novi/ossc_pcb/case-soundbox/nextcube-ext-card-mo-mount.dxf

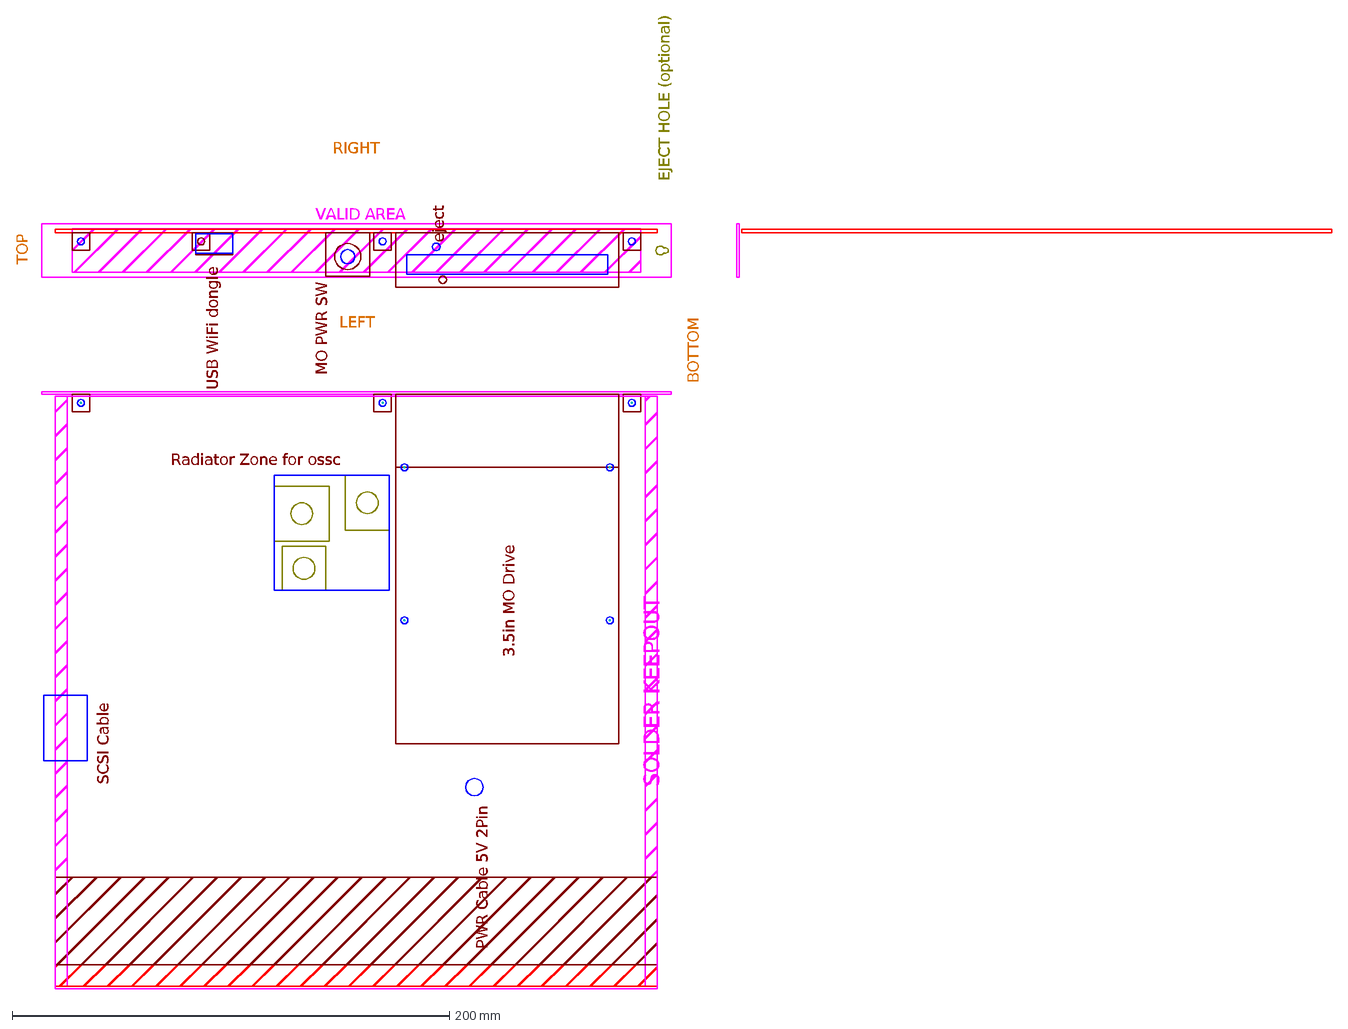
[picture p1: CAD file, 2021-07-24]
case-soundbox/nextcube-ext-card-mo-mount.dxf
VALID AREA
EJECT HOLE (optional)
BOTTOM
TOP
RIGHT
LEFT
SOLDER KEEPOUT
3.5in MO Drive
eject
MO PWR SW
USB WiFi dongle
SCSI Cable
PWR Cable 5V 2Pin
Radiator Zone for ossc
