novi/ossc_pcb/case-soundbox/nextcube-ext-card-soundbox-mount-alt1.dxf

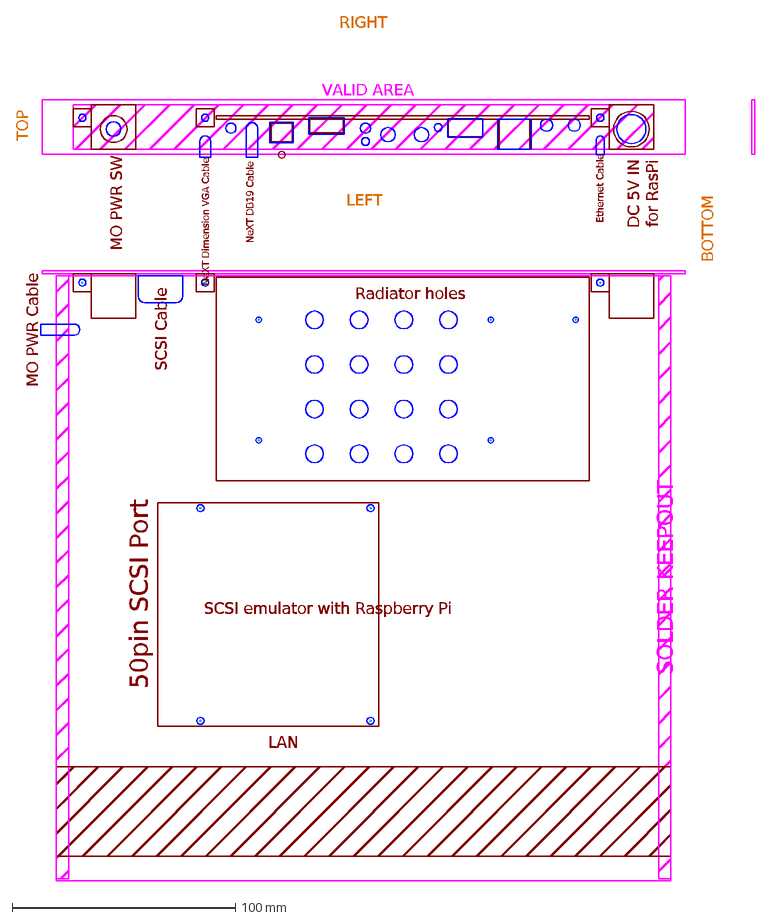
[picture p2: CAD file, 2021-07-11]
case-soundbox/nextcube-ext-card-soundbox-mount-alt1.dxf
VALID AREA
BOTTOM
TOP
RIGHT
LEFT
SOLDER KEEPOUT
50pin SCSI Port
LAN
MO PWR SW
DC 5V IN for RasPi
Ethernet Cable
NeXT DB19 Cable
NeXT Dimension VGA Cable
SCSI Cable
MO PWR Cable
Radiator holes
SCSI emulator with Raspberry Pi
