novi/ossc_pcb/case-soundbox/nextcube-ext-card-soundbox-mount.dxf

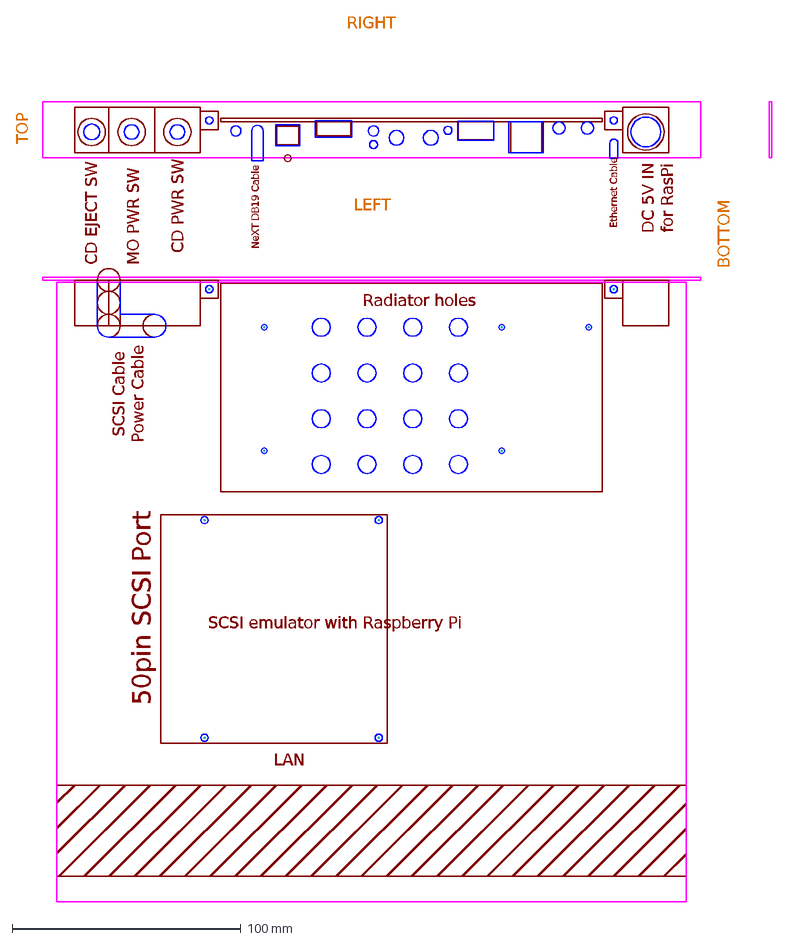
[picture p3: CAD file, 2021-05-28]
case-soundbox/nextcube-ext-card-soundbox-mount.dxf
BOTTOM
TOP
RIGHT
LEFT
50pin SCSI Port
LAN
CD EJECT SW
MO PWR SW
CD PWR SW
DC 5V IN for RasPi
Ethernet Cable
NeXT DB19 Cable
SCSI Cable Power Cable
Radiator holes
SCSI emulator with Raspberry Pi
