novi/ossc_pcb/case-soundbox/nextcube-3-and-half-mo-mount.dxf

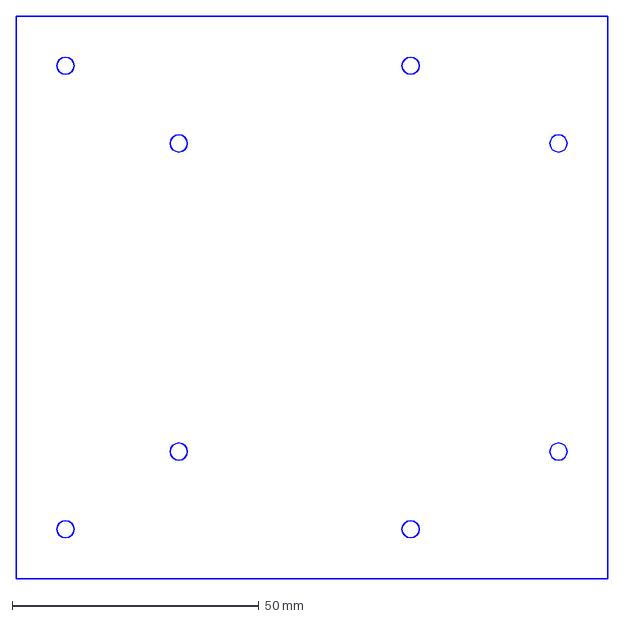
[picture p4: CAD file, 2020-09-13]
case-soundbox/nextcube-3-and-half-mo-mount.dxf
120.0 x 114.0 mm
