novi/ossc_pcb/case-soundbox/nextcube-ext-card.dxf

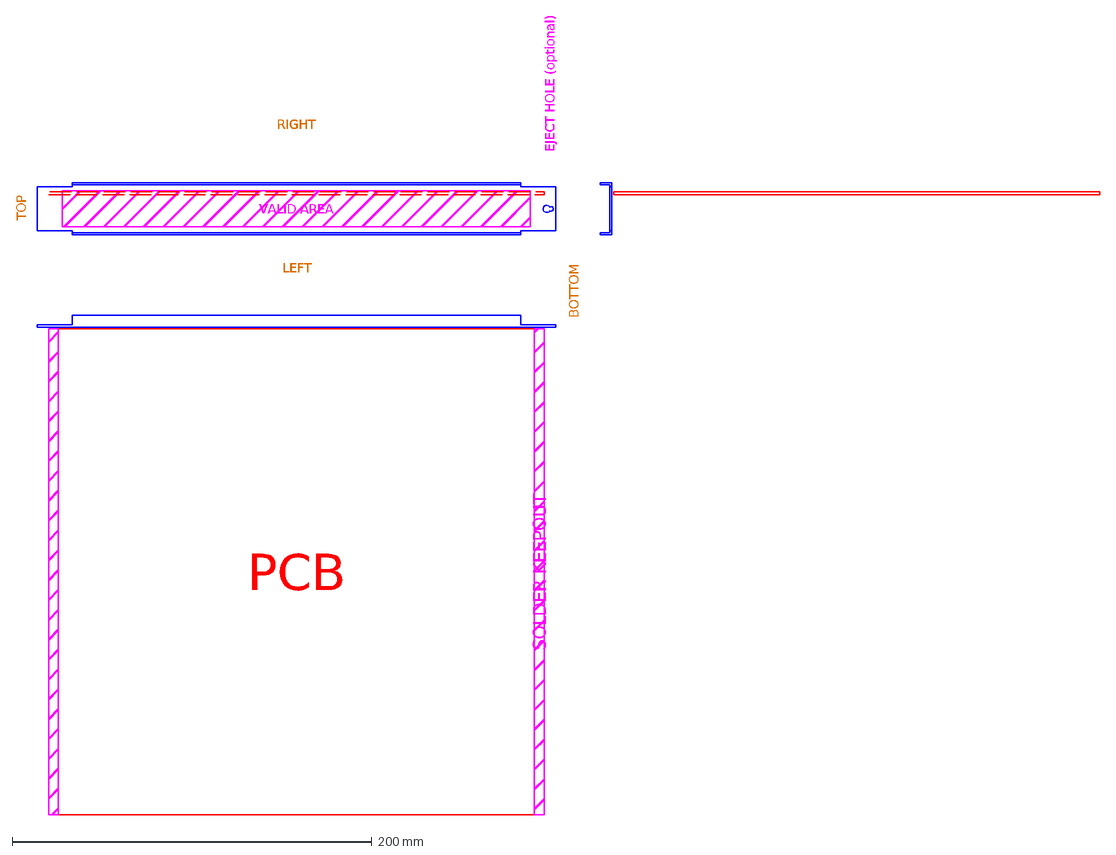
[picture p5: CAD file, 2020-09-13]
case-soundbox/nextcube-ext-card.dxf
VALID AREA
EJECT HOLE (optional)
BOTTOM
TOP
RIGHT
LEFT
PCB
SOLDER KEEPOUT
