novi/ossc_pcb/(list of files, cad)

Other CAD files:
case-soundbox/PF15-3-10D_20210228210419.dxf
