novi/ossc_pcb/ossc_board.kicad_pcb

## KiCad design ossc_board.kicad_pcb (2026-04-06)

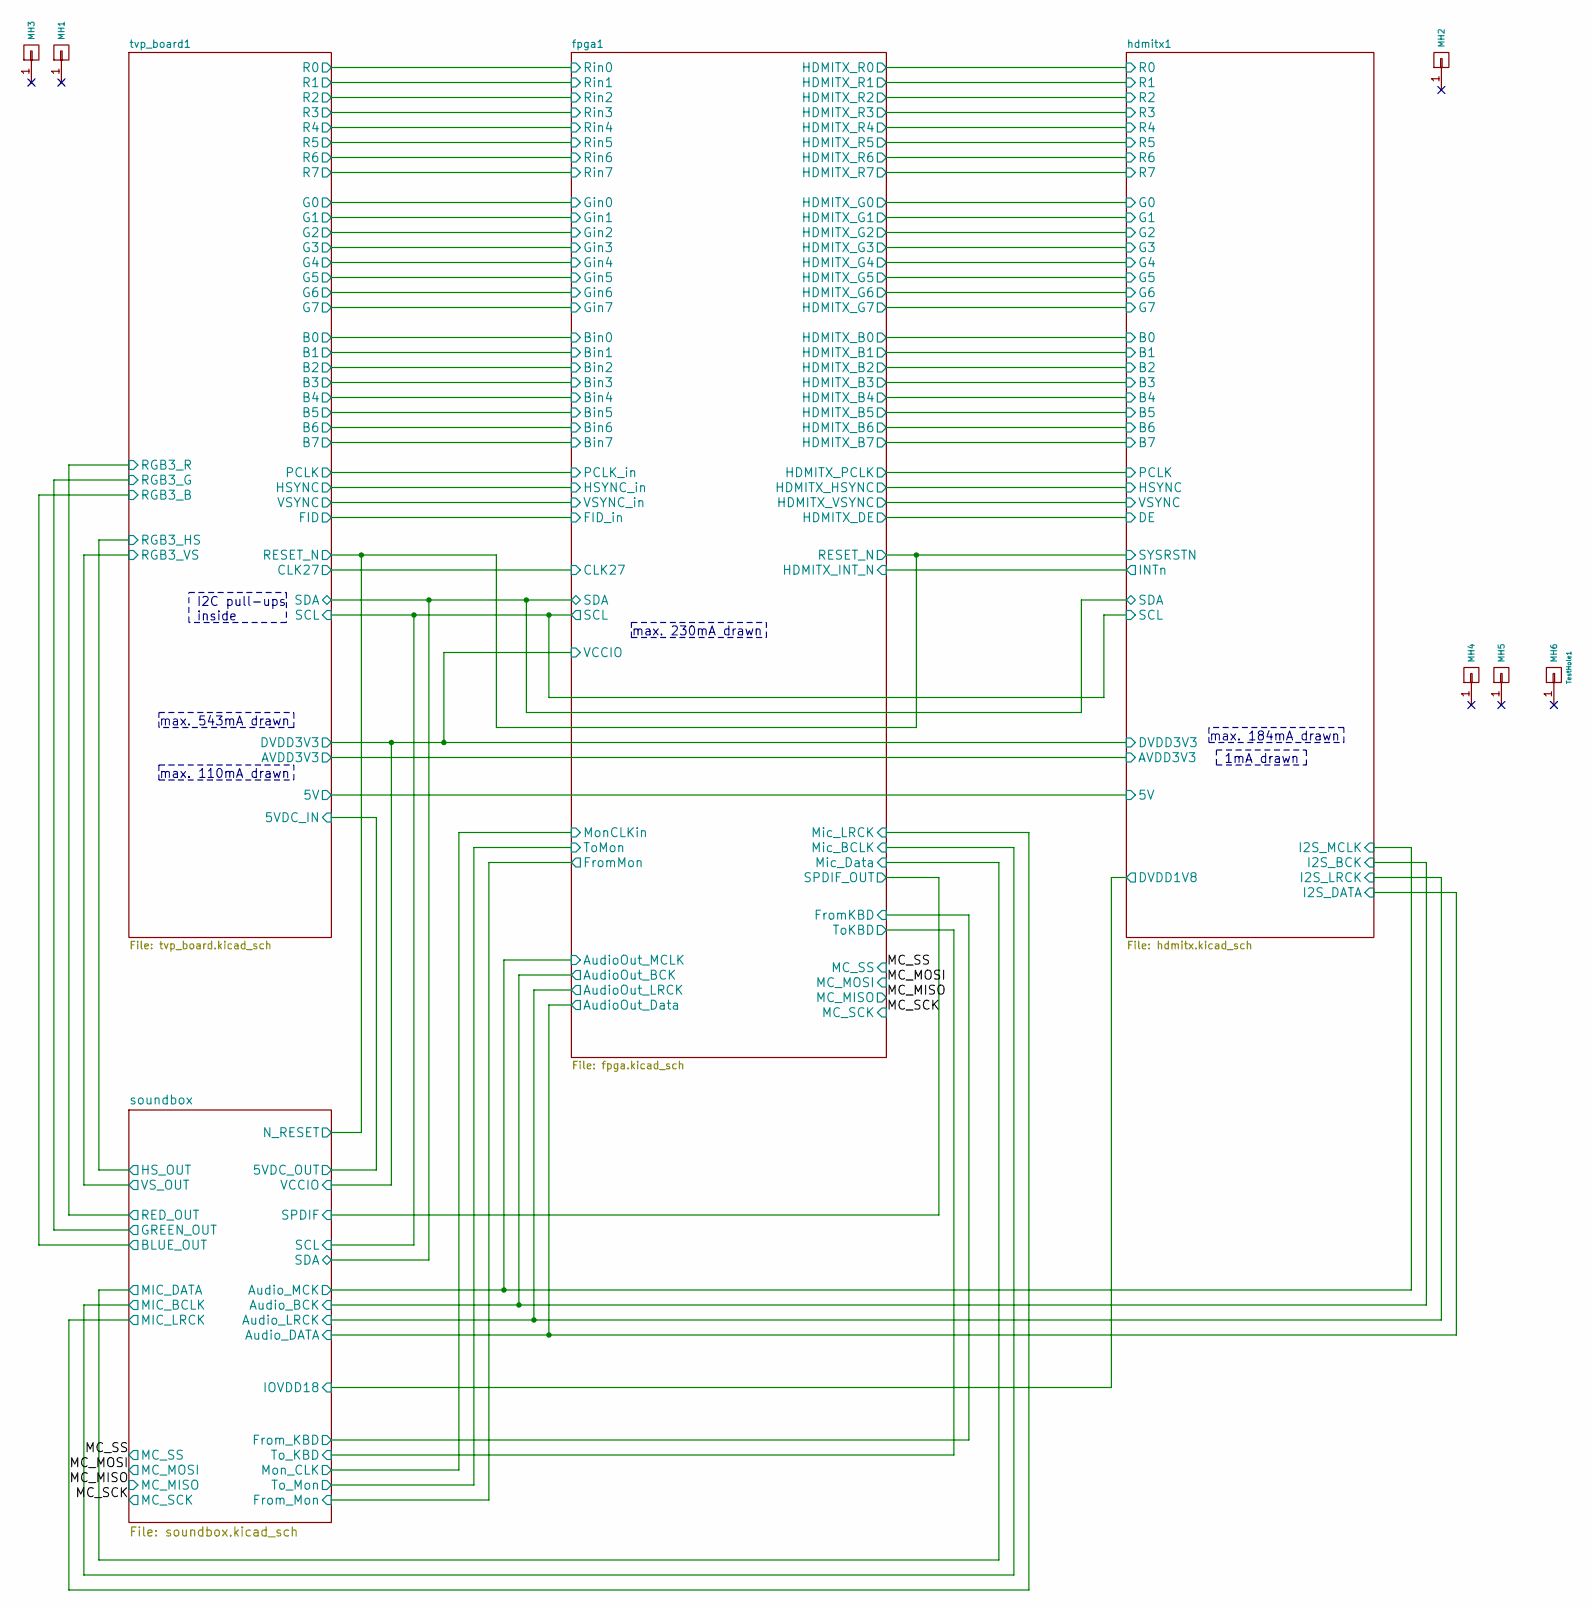
[picture p6: schematic ossc_board.kicad_sch, Open Source Scan Converter]

Parts:
MH1, MH2, MH3, MH4, MH5: CONN_1; MountingHole_2.7mm_M2.5
MH6: TestHole1; TestHole_1.0mm

Notes on the sheet:
1mA drawn
I2C pull-ups inside
max. 110mA drawn
max. 543mA drawn
max. 184mA drawn
max. 230mA drawn

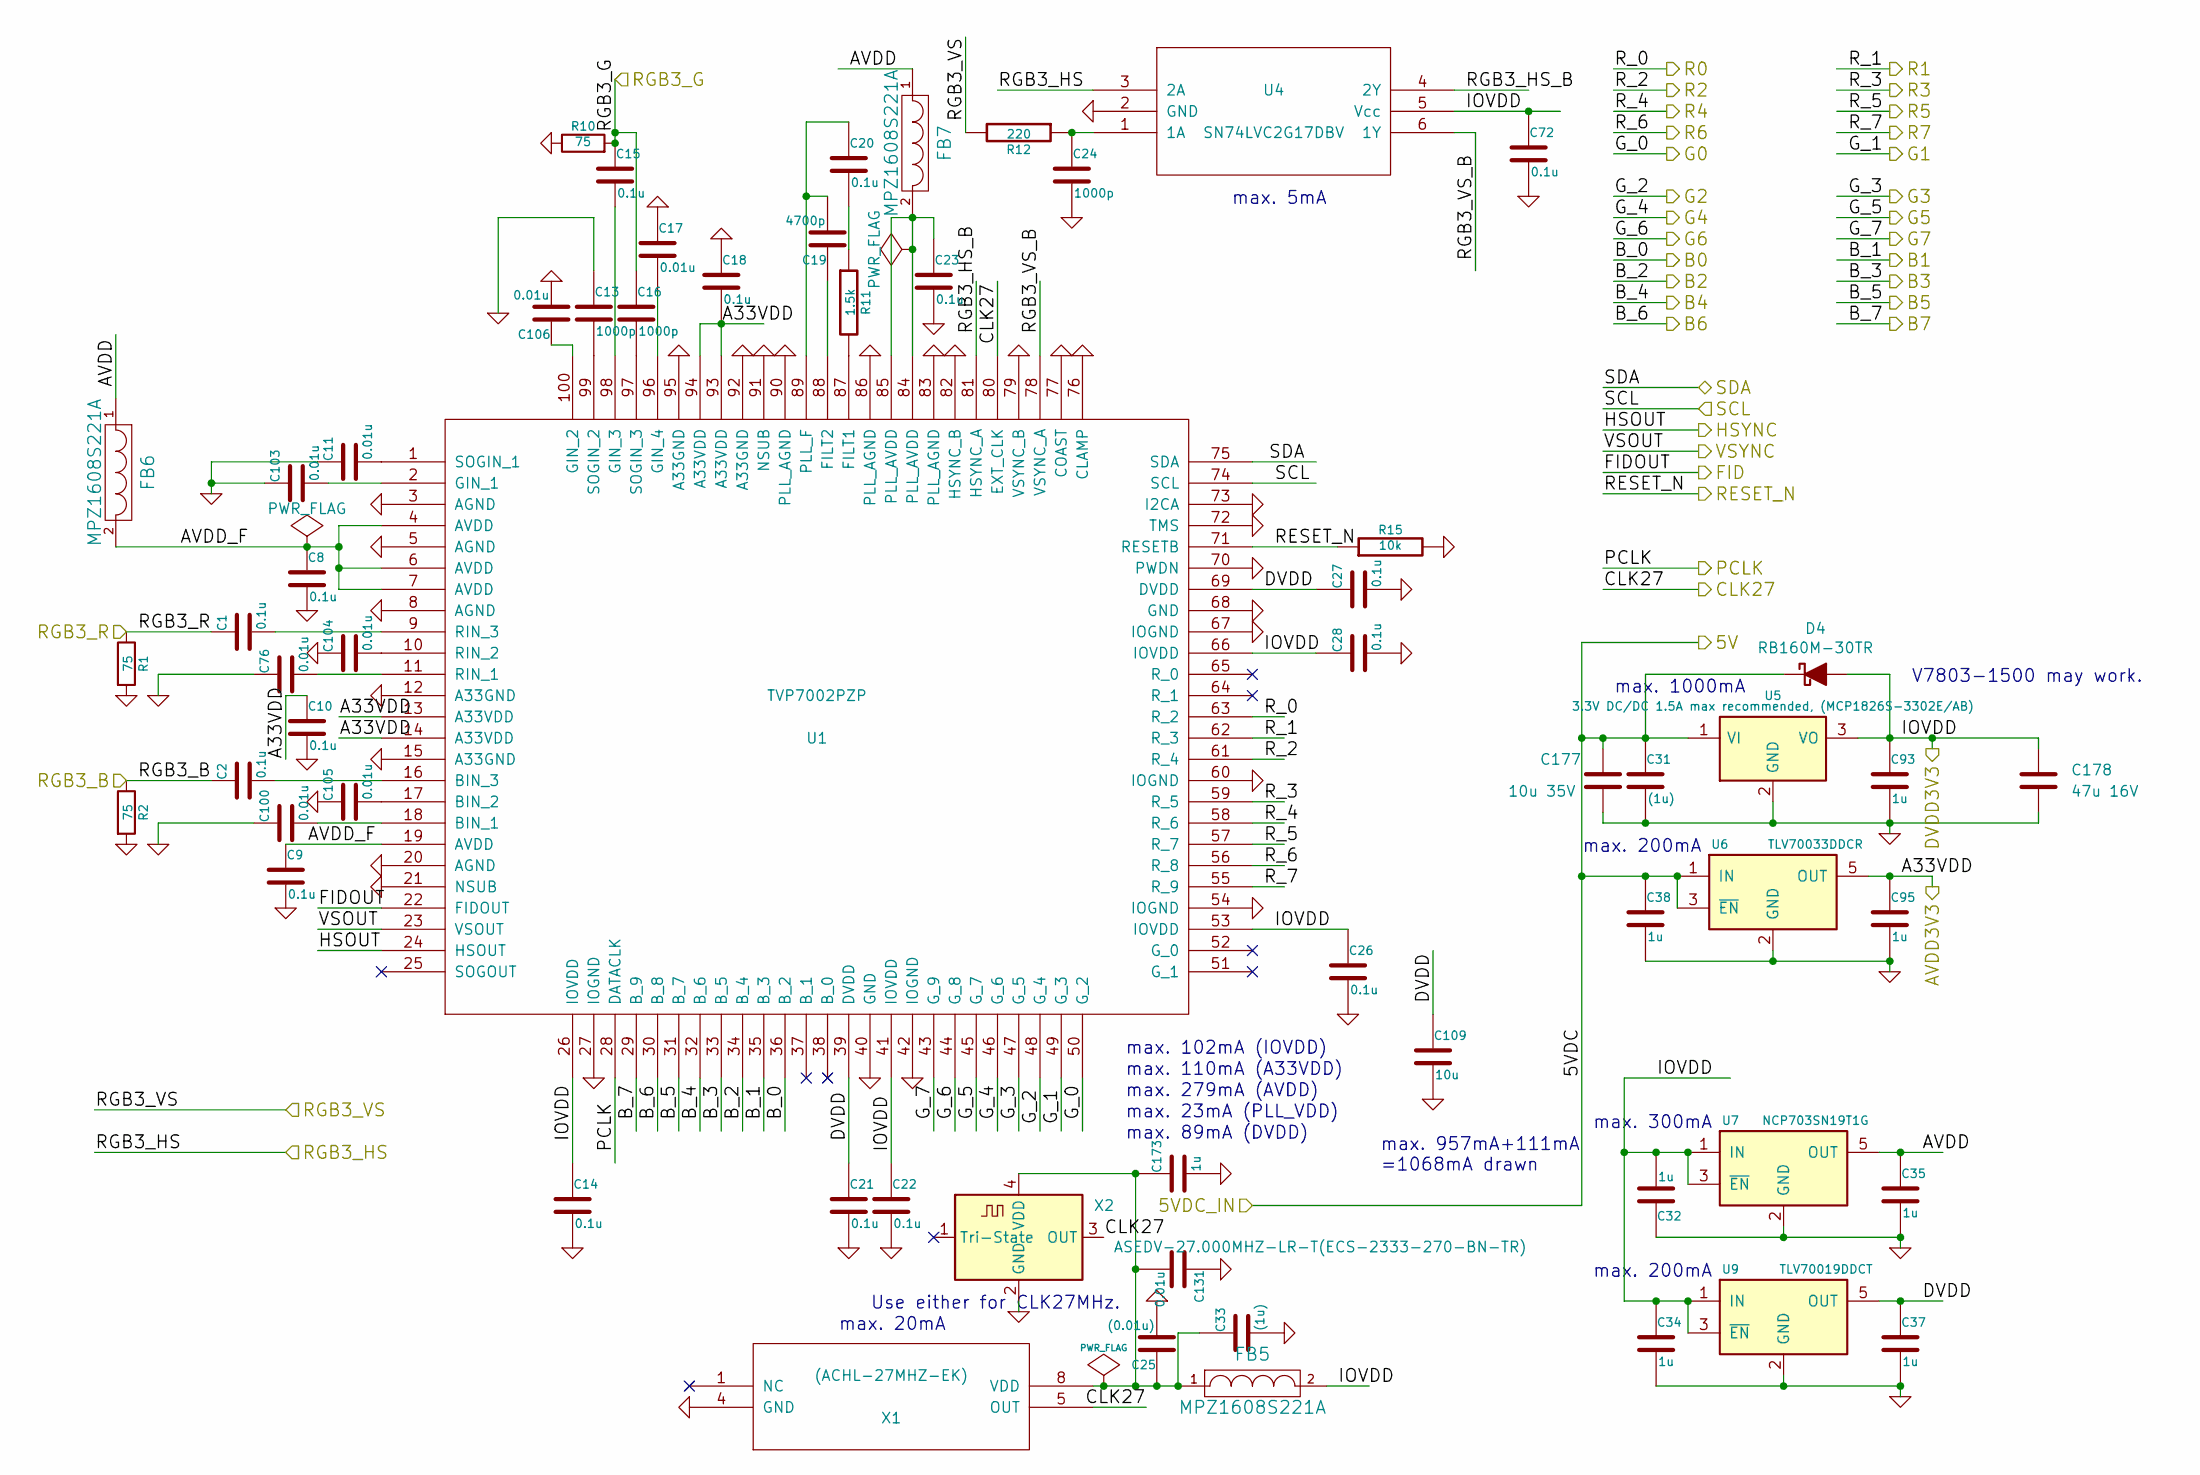
[picture p7: schematic tvp_board.kicad_sch, Open Source Scan Converter]

Parts:
C1, C2, C8, C9, C10, C14, C15, C18, C20, C21, C22, C23, C26, C27, C28, C72: 0.1u; C_0603_1608Metric_Pad1.05x0.95mm_HandSolder; Part ID GCJ188R71H104KA12D or GRM188R72A104MA35D
C11, C17, C76, C100, C103, C104, C105, C106, C131: 0.01u; C_0603_1608Metric_Pad1.05x0.95mm_HandSolder; Part ID GCM188R72A103KA37J
C13, C16, C24: 1000p; C_0603_1608Metric_Pad1.05x0.95mm_HandSolder
C19: 4700p; C_0603_1608Metric_Pad1.05x0.95mm_HandSolder
C25: (0.01u); C_0603_1608Metric_Pad1.05x0.95mm_HandSolder; Part ID GCM188R72A103KA37J
C31, C33: (1u); C_0603_1608Metric_Pad1.08x0.95mm_HandSolder; Part ID GRT188R61H105KE13D
C32, C34, C35, C37, C38, C93, C95, C173: 1u; C_0603_1608Metric_Pad1.05x0.95mm_HandSolder; Part ID GRT188R61H105KE13D
C109: 10u; C_0603_1608Metric_Pad1.05x0.95mm_HandSolder; Part ID ZRB18AR61E106ME01L
C177: 10u 35V; C_1210_3225Metric_Pad1.33x2.70mm_HandSolder; Part ID GRM32ER7YA106KA12
C178: 47u 16V; C_1210_3225Metric_Pad1.33x2.70mm_HandSolder; Part ID GRM32EC81C476KE15L
D4: RB160M-30TR; D_SOD-123_HandSoldering
FB5, FB6, FB7: MPZ1608S221A; L_0603_1608Metric_Pad1.05x0.95mm_HandSolder
R1, R2, R10: 75; R_0603_1608Metric_Pad1.05x0.95mm_HandSolder
R11: 1.5k; R_0603_1608Metric_Pad1.05x0.95mm_HandSolder
R12: 220; R_0603_1608Metric_Pad1.05x0.95mm_HandSolder
R15: 10k; R_0603_1608Metric_Pad1.05x0.95mm_HandSolder
U1: TVP7002PZP; TQFP-100_thermal
U4: SN74LVC2G17DBV; SOT-23-6_Handsoldering
U5: 3.3V DC/DC 1.5A max recommended, (MCP1826S-3302E/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; TO-220-3_Vertical; Part ID MCP1826S-3302E/AB
U6: TLV70033DDCR; SOT-23-5_HandSoldering
U7: NCP703SN19T1G; SOT-23-5_Handsoldering
U9: TLV70019DDCT; SOT-23-5_Handsoldering
X1: (ACHL-27MHZ-EK); ACHL-OSC
X2: ASEDV-27.000MHZ-LR-T(ECS-2333-270-BN-TR); Oscillator_SMD_SeikoEpson_SG8002CE-4Pin_3.2x2.5mm_HandSolde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

Connections:
/fpga1/RESET_N: R15.1, U1.71 (RESETB); also elsewhere on the board
/fpga1/SCL: U1.74 (SCL); also elsewhere on the board
/fpga1/SDA: U1.75 (SDA); also elsewhere on the board
/hdmitx1/5V: C31.1, C38.1, C177.1, D4.1 (K), U5.1 (VI), U6.1 (IN), U6.3 (~EN); also elsewhere on the board
/hdmitx1/AVCC3V3: C10.1, C18.2, C95.1, U1.13 (A33VDD), U1.14 (A33VDD), U1.93 (A33VDD), U1.94 (A33VDD), U6.5 (OUT); also elsewhere on the board
/tvp_board1/AVDD: C35.1, FB6.1, FB7.1, U7.5 (OUT)
/tvp_board1/AVDD_F: C8.1, C9.1, FB6.2, U1.4 (AVDD), U1.6 (AVDD), U1.7 (AVDD), U1.19 (AVDD)
/tvp_board1/B_0: U1.36 (B_2); also elsewhere on the board
/tvp_board1/B_1: U1.35 (B_3); also elsewhere on the board
/tvp_board1/B_2: U1.34 (B_4); also elsewhere on the board
/tvp_board1/B_3: U1.33 (B_5); also elsewhere on the board
/tvp_board1/B_4: U1.32 (B_6); also elsewhere on the board
/tvp_board1/B_5: U1.31 (B_7); also elsewhere on the board
/tvp_board1/B_6: U1.30 (B_8); also elsewhere on the board
/tvp_board1/B_7: U1.29 (B_9); also elsewhere on the board
/tvp_board1/CLK27: U1.80 (EXT_CLK), X1.5 (OUT), X2.3 (OUT); also elsewhere on the board
/tvp_board1/DVDD: C21.1, C27.1, C37.1, C109.1, U1.39 (DVDD), U1.69 (DVDD), U9.5 (OUT)
/tvp_board1/FIDOUT: U1.22 (FIDOUT); also elsewhere on the board
/tvp_board1/G_0: U1.50 (G_2); also elsewhere on the board
/tvp_board1/G_1: U1.49 (G_3); also elsewhere on the board
/tvp_board1/G_2: U1.48 (G_4); also elsewhere on the board
/tvp_board1/G_3: U1.47 (G_5); also elsewhere on the board
/tvp_board1/G_4: U1.46 (G_6); also elsewhere on the board
/tvp_board1/G_5: U1.45 (G_7); also elsewhere on the board
/tvp_board1/G_6: U1.44 (G_8); also elsewhere on the board
/tvp_board1/G_7: U1.43 (G_9); also elsewhere on the board
/tvp_board1/HSOUT: U1.24 (HSOUT); also elsewhere on the board
/tvp_board1/PCLK: U1.28 (DATACLK); also elsewhere on the board
/tvp_board1/RGB3_B: C2.1, R2.1; also elsewhere on the board
/tvp_board1/RGB3_G: C15.1, C16.1, R10.2; also elsewhere on the board
/tvp_board1/RGB3_HS: U4.3 (2A); also elsewhere on the board
/tvp_board1/RGB3_HS_B: U1.81 (HSYNC_A), U4.4 (2Y)
/tvp_board1/RGB3_R: C1.1, R1.1; also elsewhere on the board
/tvp_board1/RGB3_VS: R12.2; also elsewhere on the board
/tvp_board1/RGB3_VS_B: U1.78 (VSYNC_A), U4.6 (1Y)
/tvp_board1/R_0: U1.63 (R_2); also elsewhere on the board
/tvp_board1/R_1: U1.62 (R_3); also elsewhere on the board
/tvp_board1/R_2: U1.61 (R_4); also elsewhere on the board
/tvp_board1/R_3: U1.59 (R_5); also elsewhere on the board
/tvp_board1/R_4: U1.58 (R_6); also elsewhere on the board
/tvp_board1/R_5: U1.57 (R_7); also elsewhere on the board
/tvp_board1/R_6: U1.56 (R_8); also elsewhere on the board
/tvp_board1/R_7: U1.55 (R_9); also elsewhere on the board
/tvp_board1/VSOUT: U1.23 (VSOUT); also elsewhere on the board
GND: C8.2, C9.2, C10.2, C11.1, C13.1, C14.2, C17.1, C18.1, C21.2, C22.2, C23.2, C24.2, C25.2, C26.2, C27.2, C28.2, C31.2, C32.1, C33.2, C34.2, C35.2, C37.2, C38.2, C72.2, C76.1, C93.2, C95.2, C100.1, C103.1, C104.1, C105.1, C106.2, C109.2, C131.1, C173.2, C177.2, C178.2, R1.2, R2.2, R10.1, R15.2, U1.3 (AGND), U1.5 (AGND), U1.8 (AGND), U1.12 (A33GND), U1.15 (A33GND), U1.20 (AGND), U1.21 (NSUB), U1.27 (IOGND), U1.40 (GND), U1.42 (IOGND), U1.54 (IOGND), U1.60 (IOGND), U1.67 (IOGND), U1.68 (GND), U1.70 (PWDN), U1.72 (TMS), U1.73 (I2CA), U1.76 (CLAMP), U1.77 (COAST), U1.79 (VSYNC_B), U1.82 (HSYNC_B), U1.83 (PLL_AGND), U1.86 (PLL_AGND), U1.90 (PLL_AGND), U1.91 (NSUB), U1.92 (A33GND), U1.95 (A33GND), U4.2 (GND), U5.2 (GND), U6.2 (GND), U7.2 (GND), U9.2 (GND), X1.4 (GND), X2.2 (GND); also elsewhere on the board
unnamed: C20.2, R11.1
unnamed: C23.1, FB7.2, U1.84 (PLL_AVDD), U1.85 (PLL_AVDD)
unnamed: C100.2, U1.18 (BIN_1)
unnamed: C105.2, U1.17 (BIN_2)
unnamed: C2.2, U1.16 (BIN_3)
unnamed: R11.2, U1.87 (FILT1)
unnamed: C19.1, U1.88 (FILT2)
unnamed: C103.2, U1.2 (GIN_1)
unnamed: C106.1, U1.100 (GIN_2)
unnamed: C15.2, U1.98 (GIN_3)
unnamed: C17.2, U1.96 (GIN_4)
unnamed: C19.2, C20.1, U1.89 (PLL_F)
unnamed: C76.2, U1.11 (RIN_1)
unnamed: C104.2, U1.10 (RIN_2)
unnamed: C1.2, U1.9 (RIN_3)
unnamed: C11.2, U1.1 (SOGIN_1)
unnamed: C13.2, U1.99 (SOGIN_2)
unnamed: C16.2, U1.97 (SOGIN_3)
unnamed: C24.1, R12.1, U4.1 (1A)
unnamed: C25.1, C33.1, C131.2, C173.1, FB5.1, X1.8 (VDD), X2.4 (VDD)
VCC: C14.1, C22.1, C26.1, C28.1, C32.2, C34.1, C72.1, C93.1, C178.1, D4.2 (A), FB5.2, U1.26 (IOVDD), U1.41 (IOVDD), U1.53 (IOVDD), U1.66 (IOVDD), U4.5 (Vcc), U5.3 (VO), U7.1 (IN), U7.3 (~EN), U9.1 (IN), U9.3 (~EN); also elsewhere on the board

Notes on the sheet:
max. 1000mA
max. 110mA (A33VDD)
max. 279mA (AVDD)
max. 300mA
max. 23mA (PLL_VDD)
V7803-1500 may work.
max. 200mA
max. 957mA+111mA =1068mA drawn
max. 102mA (IOVDD)
Use either for CLK27MHz.
max. 5mA
max. 20mA
max. 89mA (DVDD)

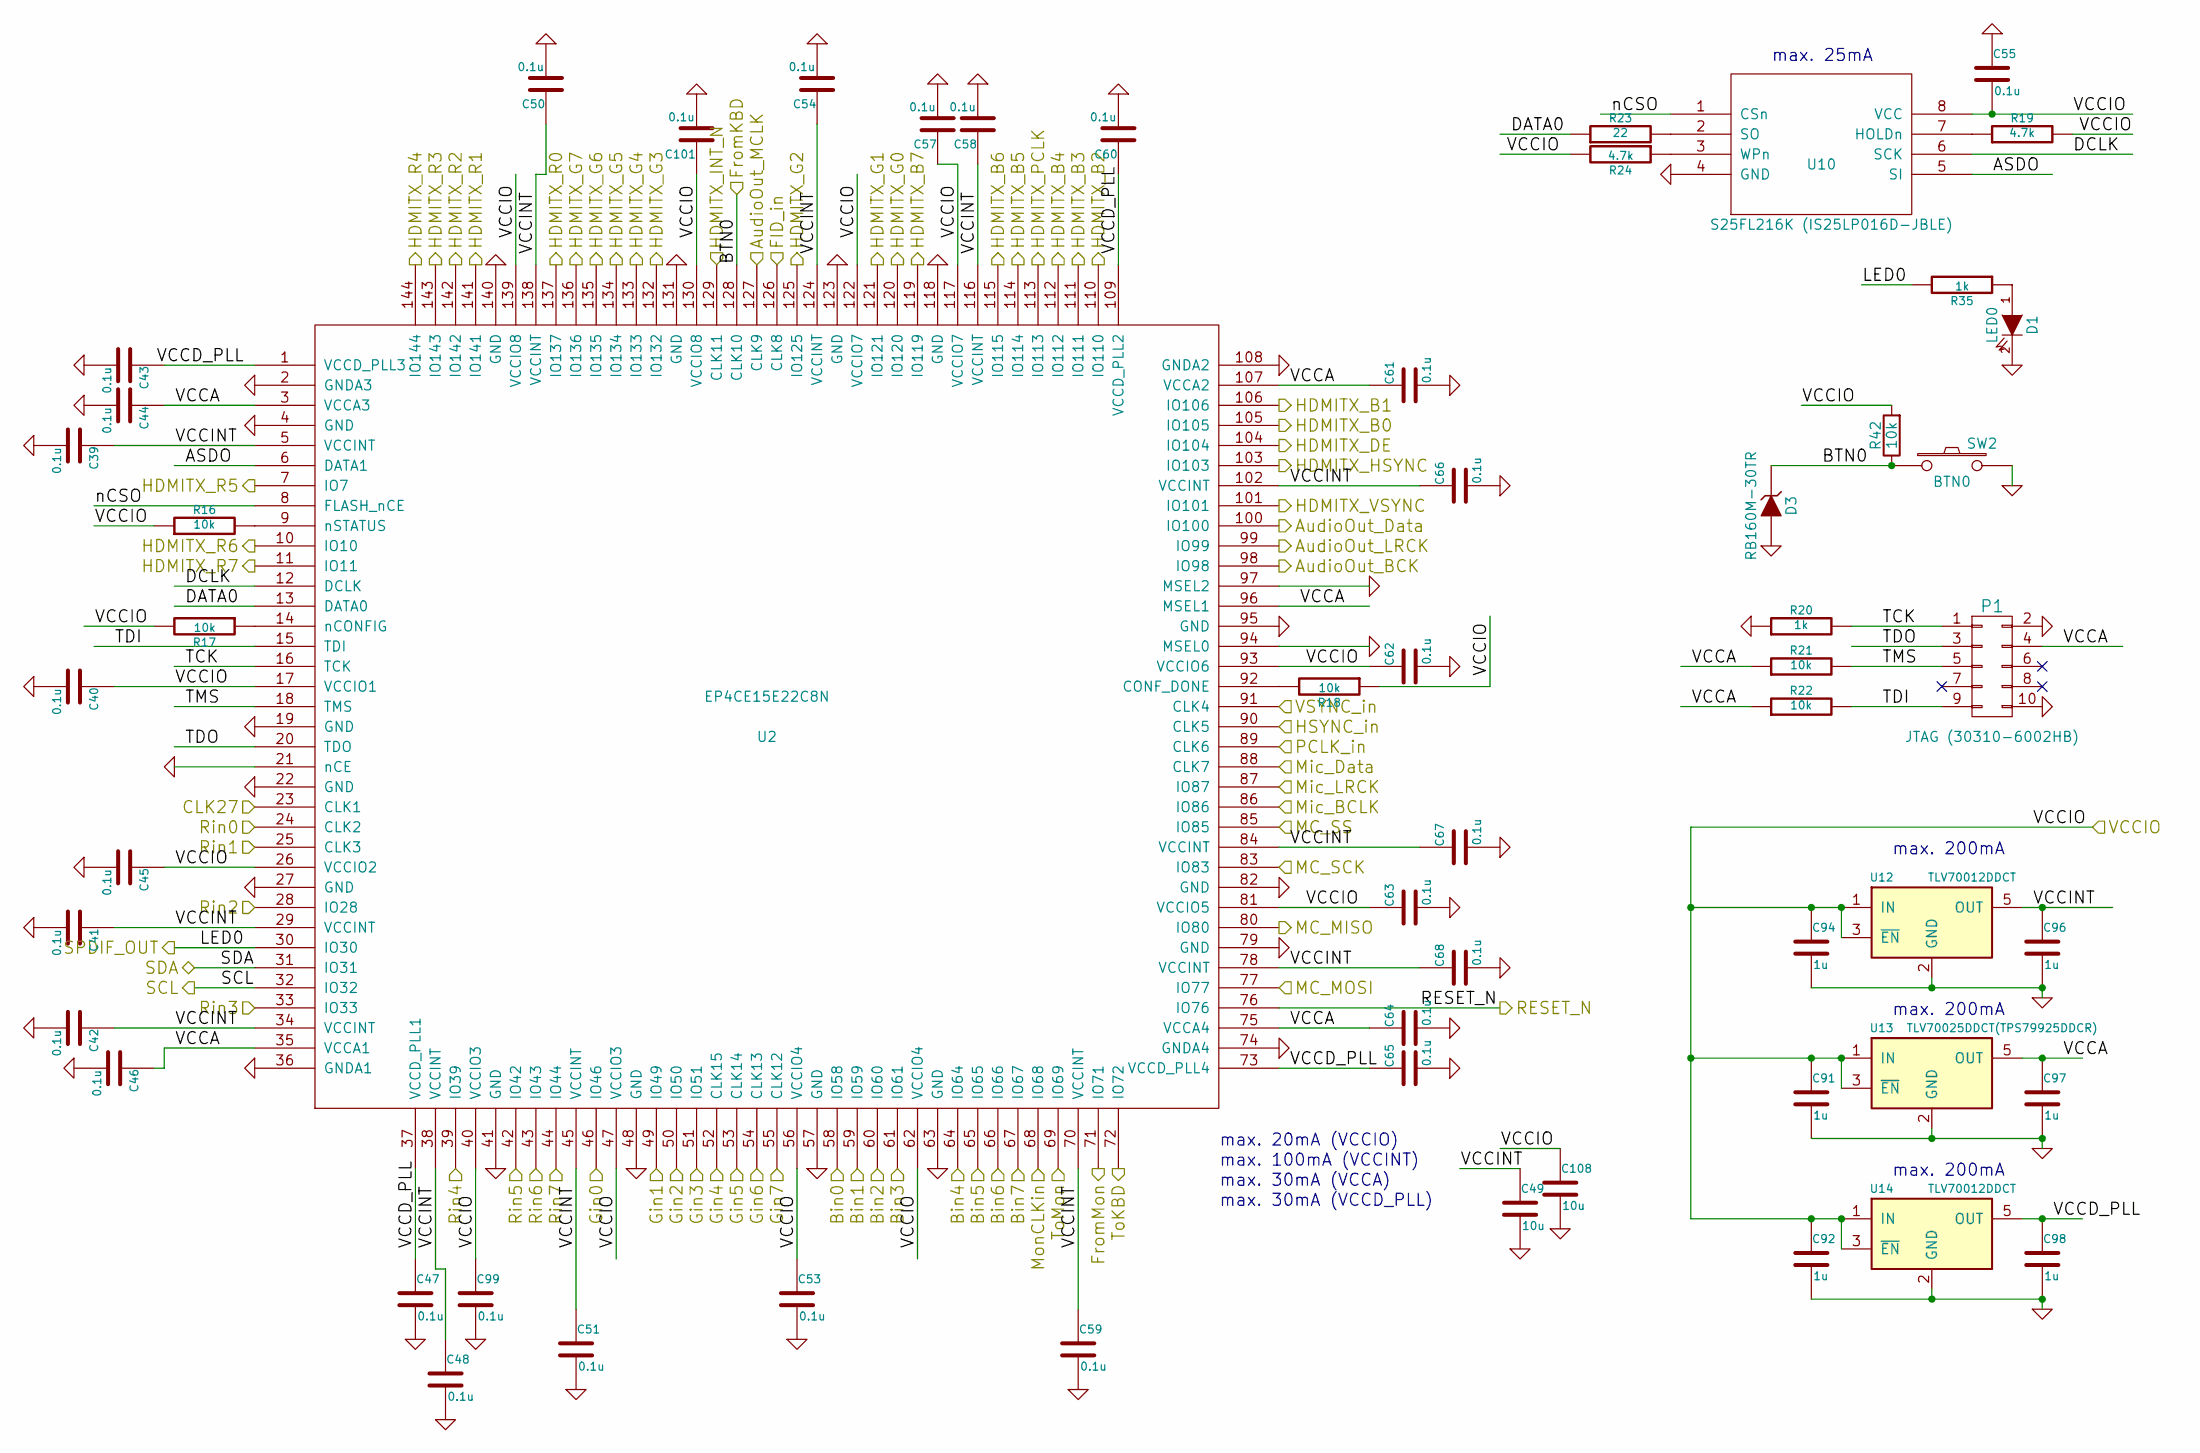
[picture p8: schematic fpga.kicad_sch, Open Source Scan Converter]

Parts:
C39, C40, C41, C42, C43, C44, C45, C46, C47, C48, C50, C51, C53, C54, C55, C57, C58, C59, C60, C61, C62, C63, C64, C65, C66, C67, C68, C99, C101: 0.1u; C_0603_1608Metric_Pad1.05x0.95mm_HandSolder; Part ID GCJ188R71H104KA12D or GRM188R72A104MA35D
C49, C108: 10u; C_0603_1608Metric_Pad1.05x0.95mm_HandSolder; Part ID ZRB18AR61E106ME01L
C91, C92, C94, C96, C97, C98: 1u; C_0603_1608Metric_Pad1.05x0.95mm_HandSolder; Part ID GRT188R61H105KE13D
D1: LED0; LED_D3.0mm_Horizontal_O1.27mm_Z6.0mm
D3: RB160M-30TR; D_SOD-123_HandSoldering
P1: JTAG (30310-6002HB); VASCH5x2
R16, R17, R18, R21, R22, R42: 10k; R_0603_1608Metric_Pad1.05x0.95mm_HandSolder
R19, R24: 4.7k; R_0603_1608Metric_Pad1.05x0.95mm_HandSolder
R20, R35: 1k; R_0603_1608Metric_Pad1.05x0.95mm_HandSolder
R23: 22; R_0603_1608Metric_Pad1.05x0.95mm_HandSolder
SW2: BTN0; SW_Tactile_SKHH_Angled; Part ID (1-1825027-1 / 2-1825027-0)
U2: EP4CE15E22C8N; TQFP-144_thermal
U10: S25FL216K (IS25LP016D-JBLE); SOIC-8_3.9x4.9mm_Pitch1.27mm_Handsoldering
U12, U14: TLV70012DDCT; SOT-23-5_Handsoldering
U13: TLV70025DDCT(TPS79925DDCR); SOT-23-5_Handsoldering

Connections:
/MC_MISO: U2.80 (IO80); also elsewhere on the board
/MC_MOSI: U2.77 (IO77); also elsewhere on the board
/MC_SCK: U2.83 (IO83); also elsewhere on the board
/MC_SS: U2.85 (IO85); also elsewhere on the board
/fpga1/ASDO: U2.6 (DATA1), U10.5 (SI)
/fpga1/BTN0: D3.1 (K), R42.1, SW2.1, U2.128 (CLK10); also elsewhere on the board
/fpga1/DATA0: R23.1, U2.13 (DATA0)
/fpga1/DCLK: U2.12 (DCLK), U10.6 (SCK)
/fpga1/FromMon: U2.71 (IO71); also elsewhere on the board
/fpga1/HDMITX_B0: U2.105 (IO105); also elsewhere on the board
/fpga1/HDMITX_B1: U2.106 (IO106); also elsewhere on the board
/fpga1/HDMITX_B2: U2.110 (IO110); also elsewhere on the board
/fpga1/HDMITX_B3: U2.111 (IO111); also elsewhere on the board
/fpga1/HDMITX_B4: U2.112 (IO112); also elsewhere on the board
/fpga1/HDMITX_B5: U2.114 (IO114); also elsewhere on the board
/fpga1/HDMITX_B6: U2.115 (IO115); also elsewhere on the board
/fpga1/HDMITX_B7: U2.119 (IO119); also elsewhere on the board
/fpga1/HDMITX_DE: U2.104 (IO104); also elsewhere on the board
/fpga1/HDMITX_G0: U2.120 (IO120); also elsewhere on the board
/fpga1/HDMITX_G1: U2.121 (IO121); also elsewhere on the board
/fpga1/HDMITX_G2: U2.125 (IO125); also elsewhere on the board
/fpga1/HDMITX_G3: U2.132 (IO132); also elsewhere on the board
/fpga1/HDMITX_G4: U2.133 (IO133); also elsewhere on the board
/fpga1/HDMITX_G5: U2.134 (IO134); also elsewhere on the board
/fpga1/HDMITX_G6: U2.135 (IO135); also elsewhere on the board
/fpga1/HDMITX_G7: U2.136 (IO136); also elsewhere on the board
/fpga1/HDMITX_HSYNC: U2.103 (IO103); also elsewhere on the board
/fpga1/HDMITX_INT_N: U2.129 (CLK11); also elsewhere on the board
/fpga1/HDMITX_PCLK: U2.113 (IO113); also elsewhere on the board
/fpga1/HDMITX_R0: U2.137 (IO137); also elsewhere on the board
/fpga1/HDMITX_R1: U2.141 (IO141); also elsewhere on the board
/fpga1/HDMITX_R2: U2.142 (IO142); also elsewhere on the board
/fpga1/HDMITX_R3: U2.143 (IO143); also elsewhere on the board
/fpga1/HDMITX_R4: U2.144 (IO144); also elsewhere on the board
/fpga1/HDMITX_R5: U2.7 (IO7); also elsewhere on the board
/fpga1/HDMITX_R6: U2.10 (IO10); also elsewhere on the board
/fpga1/HDMITX_R7: U2.11 (IO11); also elsewhere on the board
/fpga1/HDMITX_VSYNC: U2.101 (IO101); also elsewhere on the board
/fpga1/LED0: R35.2, U2.30 (IO30); also elsewhere on the board
/fpga1/Mic_BCLK: U2.86 (IO86); also elsewhere on the board
/fpga1/Mic_Data: U2.88 (CLK7); also elsewhere on the board
/fpga1/Mic_LRCK: U2.87 (IO87); also elsewhere on the board
/fpga1/MonCLKin: U2.68 (IO68); also elsewhere on the board
/fpga1/RESET_N: U2.76 (IO76); also elsewhere on the board
/fpga1/SCL: U2.32 (IO32); also elsewhere on the board
/fpga1/SDA: U2.31 (IO31); also elsewhere on the board
/fpga1/TCK: P1.1, R20.2, U2.16 (TCK)
/fpga1/TDI: P1.9, R22.2, U2.15 (TDI)
/fpga1/TDO: P1.3, U2.20 (TDO)
/fpga1/TMS: P1.5, R21.2, U2.18 (TMS)
/fpga1/ToKBD: U2.72 (IO72); also elsewhere on the board
/fpga1/ToMon: U2.69 (IO69); also elsewhere on the board
/fpga1/VCCA: C44.1, C46.1, C61.1, C64.1, C97.1, P1.4, R21.1, R22.1, U2.3 (VCCA3), U2.35 (VCCA1), U2.75 (VCCA4), U2.96 (MSEL1), U2.107 (VCCA2), U13.5 (OUT)
/fpga1/VCCD_PLL: C43.1, C47.1, C60.1, C65.1, C98.1, U2.1 (VCCD_PLL3), U2.37 (VCCD_PLL1), U2.73 (VCCD_PLL4), U2.109 (VCCD_PLL2), U14.5 (OUT)
/fpga1/VCCINT: C39.1, C41.1, C42.1, C48.1, C49.1, C50.1, C51.1, C54.1, C58.1, C59.1, C66.1, C67.1, C68.1, C96.1, U2.5 (VCCINT), U2.29 (VCCINT), U2.34 (VCCINT), U2.38 (VCCINT), U2.45 (VCCINT), U2.70 (VCCINT), U2.78 (VCCINT), U2.84 (VCCINT), U2.102 (VCCINT), U2.116 (VCCINT), U2.124 (VCCINT), U2.138 (VCCINT), U12.5 (OUT)
/fpga1/nCSO: U2.8 (FLASH_nCE), U10.1 (CSn)
/hdmitx1/I2S_BCK: U2.98 (IO98); also elsewhere on the board
/hdmitx1/I2S_DATA: U2.100 (IO100); also elsewhere on the board
/hdmitx1/I2S_LRCK: U2.99 (IO99); also elsewhere on the board
/soundbox/MCLK: U2.127 (CLK9); also elsewhere on the board
/tvp_board1/B_0: U2.58 (IO58); also elsewhere on the board
/tvp_board1/B_1: U2.59 (IO59); also elsewhere on the board
/tvp_board1/B_2: U2.60 (IO60); also elsewhere on the board
/tvp_board1/B_3: U2.61 (IO61); also elsewhere on the board
/tvp_board1/B_4: U2.64 (IO64); also elsewhere on the board
/tvp_board1/B_5: U2.65 (IO65); also elsewhere on the board
/tvp_board1/B_6: U2.66 (IO66); also elsewhere on the board
/tvp_board1/B_7: U2.67 (IO67); also elsewhere on the board
/tvp_board1/CLK27: U2.23 (CLK1); also elsewhere on the board
/tvp_board1/FIDOUT: U2.126 (CLK8); also elsewhere on the board
/tvp_board1/G_0: U2.46 (IO46); also elsewhere on the board
/tvp_board1/G_1: U2.49 (IO49); also elsewhere on the board
/tvp_board1/G_2: U2.50 (IO50); also elsewhere on the board
/tvp_board1/G_3: U2.51 (IO51); also elsewhere on the board
/tvp_board1/G_4: U2.52 (CLK15); also elsewhere on the board
/tvp_board1/G_5: U2.53 (CLK14); also elsewhere on the board
/tvp_board1/G_6: U2.54 (CLK13); also elsewhere on the board
/tvp_board1/G_7: U2.55 (CLK12); also elsewhere on the board
/tvp_board1/HSOUT: U2.90 (CLK5); also elsewhere on the board
/tvp_board1/PCLK: U2.89 (CLK6); also elsewhere on the board
/tvp_board1/R_0: U2.24 (CLK2); also elsewhere on the board
/tvp_board1/R_1: U2.25 (CLK3); also elsewhere on the board
/tvp_board1/R_2: U2.28 (IO28); also elsewhere on the board
/tvp_board1/R_3: U2.33 (IO33); also elsewhere on the board
/tvp_board1/R_4: U2.39 (IO39); also elsewhere on the board
/tvp_board1/R_5: U2.42 (IO42); also elsewhere on the board
/tvp_board1/R_6: U2.43 (IO43); also elsewhere on the board
/tvp_board1/R_7: U2.44 (IO44); also elsewhere on the board
/tvp_board1/VSOUT: U2.91 (CLK4); also elsewhere on the board
GND: C39.2, C40.2, C41.2, C42.2, C43.2, C44.2, C45.2, C46.2, C47.2, C48.2, C49.2, C50.2, C51.2, C53.2, C54.2, C55.1, C57.2, C58.2, C59.2, C60.2, C61.2, C62.2, C63.2, C64.2, C65.2, C66.2, C67.2, C68.2, C91.2, C92.2, C94.2, C96.2, C97.2, C98.2, C99.2, C101.2, C108.2, D1.2 (K), D3.2 (A), P1.2, P1.10, R20.1, SW2.2, U2.2 (GNDA3), U2.4 (GND), U2.19 (GND), U2.21 (nCE), U2.22 (GND), U2.27 (GND), U2.36 (GNDA1), U2.41 (GND), U2.48 (GND), U2.57 (GND), U2.63 (GND), U2.74 (GNDA4), U2.79 (GND), U2.82 (GND), U2.94 (MSEL0), U2.95 (GND), U2.97 (MSEL2), U2.108 (GNDA2), U2.118 (GND), U2.123 (GND), U2.131 (GND), U2.140 (GND), U10.4 (GND), U12.2 (GND), U13.2 (GND), U14.2 (GND); also elsewhere on the board
unnamed: D1.1 (A), R35.1
unnamed: R18.2, U2.92 (CONF_DONE)
unnamed: R17.1, U2.14 (nCONFIG)
unnamed: R16.2, U2.9 (nSTATUS)
unnamed: R19.1, U10.7 (HOLDn)
unnamed: R23.2, U10.2 (SO)
unnamed: R24.1, U10.3 (WPn)
VCC: C40.1, C45.1, C53.1, C55.2, C57.1, C62.1, C63.1, C91.1, C92.1, C94.1, C99.1, C101.1, C108.1, R16.1, R17.2, R18.1, R19.2, R24.2, R42.2, U2.17 (VCCIO1), U2.26 (VCCIO2), U2.40 (VCCIO3), U2.47 (VCCIO3), U2.56 (VCCIO4), U2.62 (VCCIO4), U2.81 (VCCIO5), U2.93 (VCCIO6), U2.117 (VCCIO7), U2.122 (VCCIO7), U2.130 (VCCIO8), U2.139 (VCCIO8), U10.8 (VCC), U12.1 (IN), U12.3 (~EN), U13.1 (IN), U13.3 (~EN), U14.1 (IN), U14.3 (~EN); also elsewhere on the board

Notes on the sheet:
max. 30mA (VCCA)
max. 20mA (VCCIO)
max. 200mA
max. 25mA
max. 100mA (VCCINT)
max. 30mA (VCCD_PLL)
