novi/ossc_pcb/ossc_board.kicad_pcb

## KiCad design ossc_board.kicad_pcb (continued)

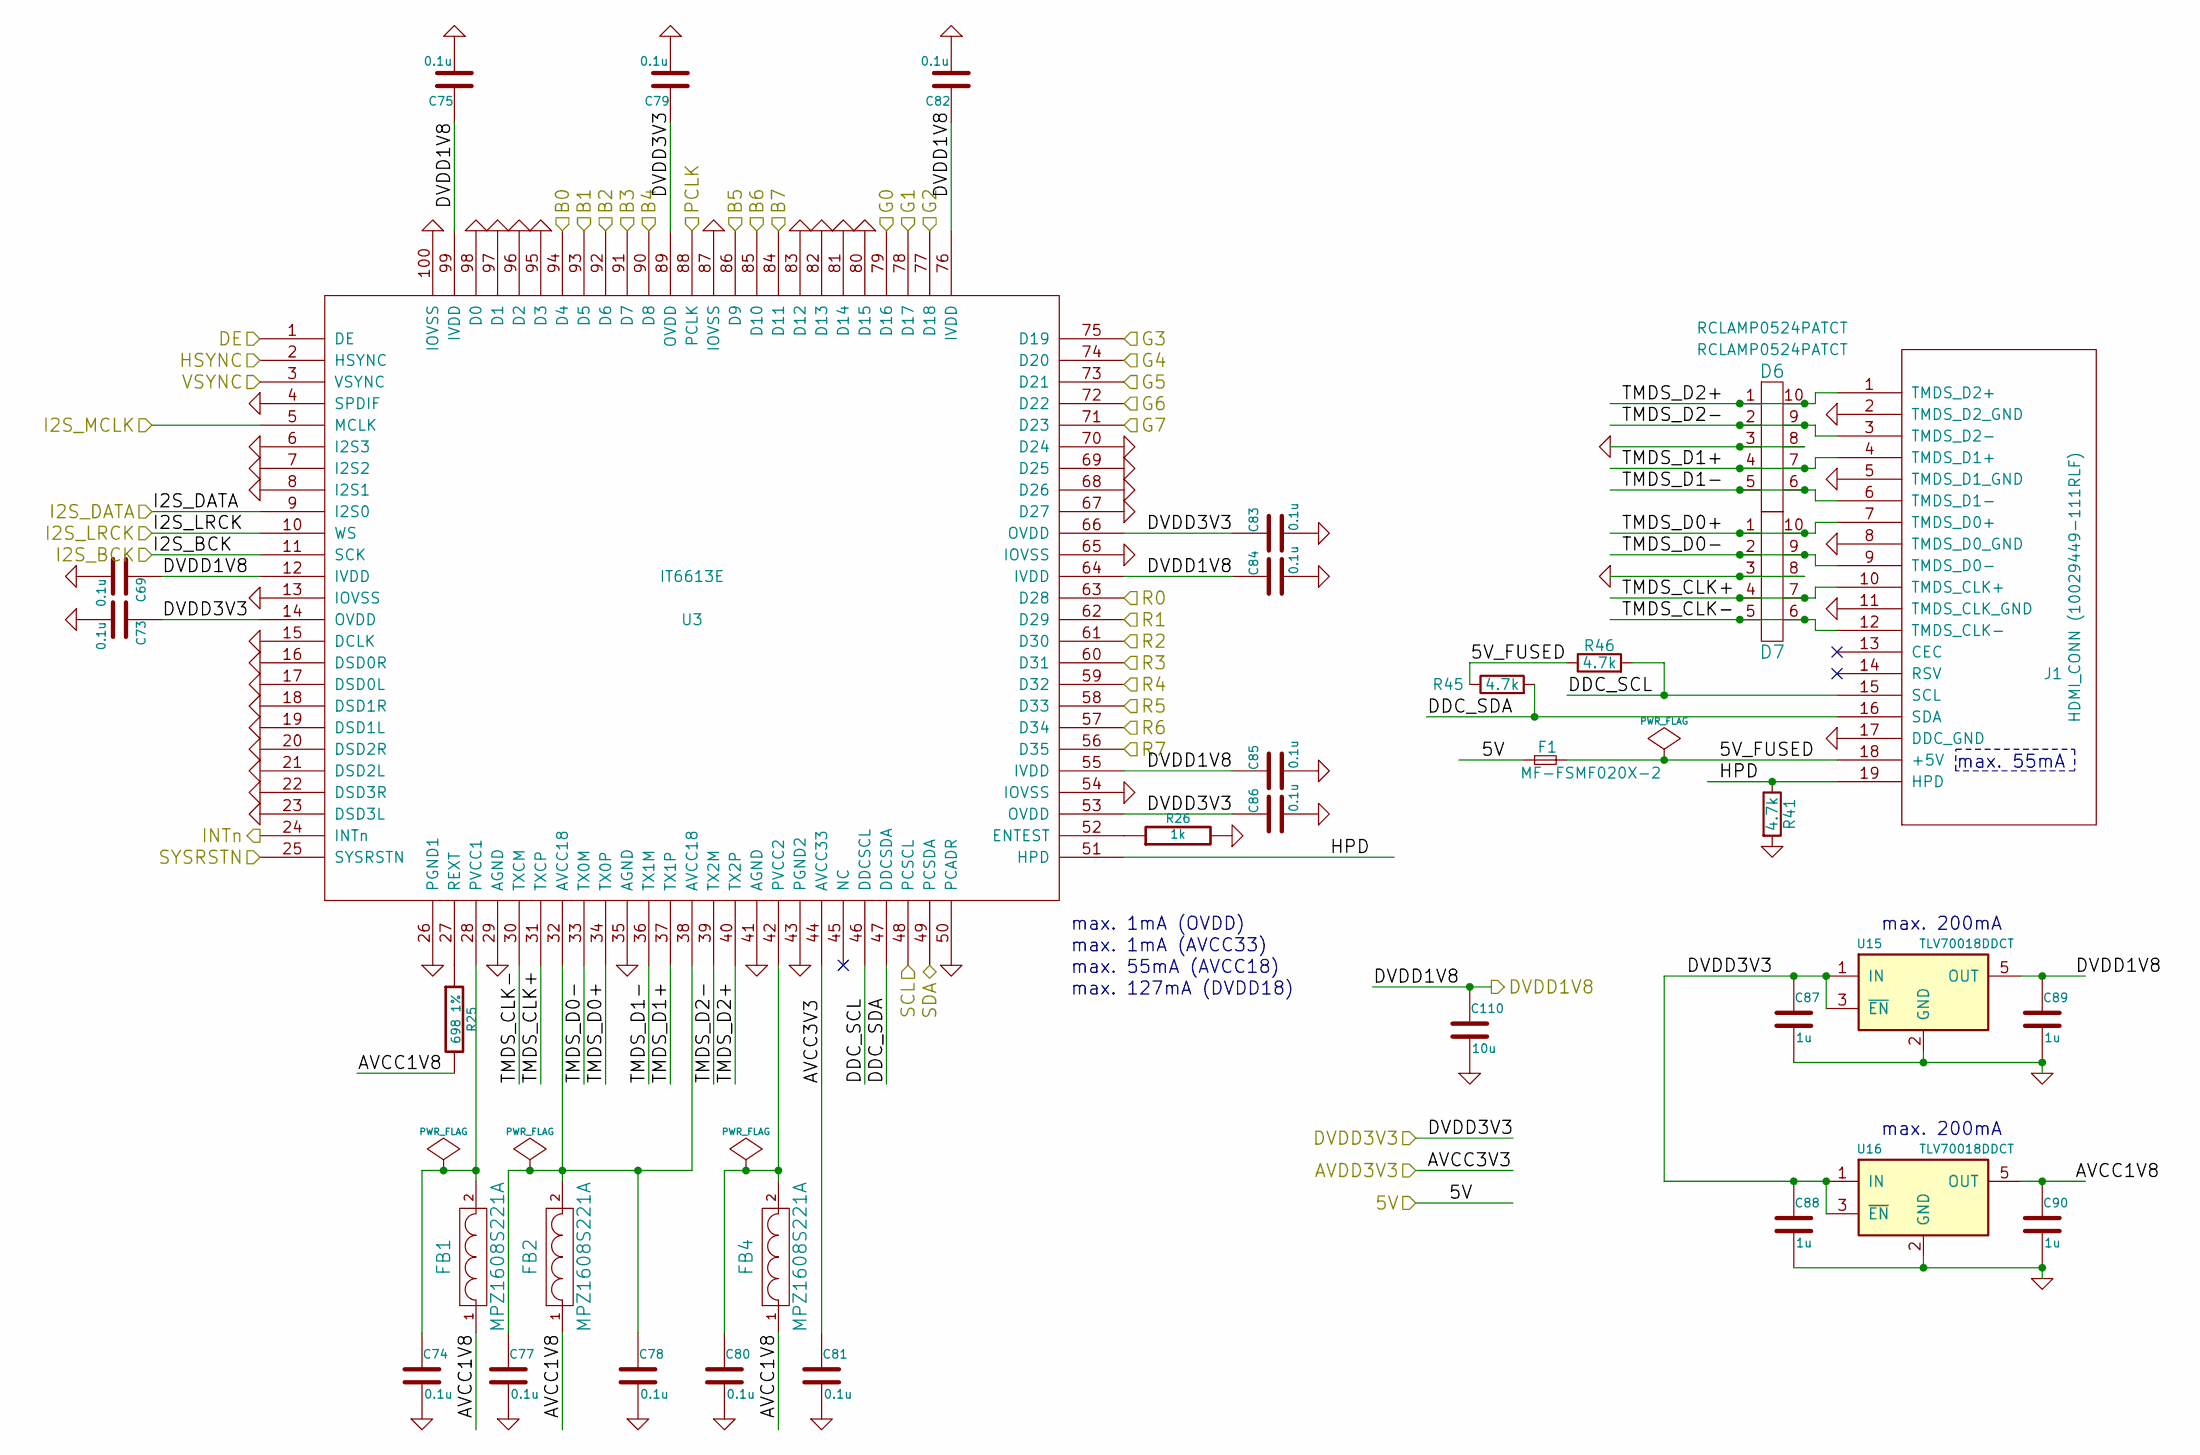
[picture p9: schematic hdmitx.kicad_sch, Open Source Scan Converter]

Parts:
C69, C73, C74, C75, C77, C78, C79, C80, C81, C82, C83, C84, C85, C86: 0.1u; C_0603_1608Metric_Pad1.05x0.95mm_HandSolder; Part ID GCJ188R71H104KA12D or GRM188R72A104MA35D
C87, C88, C89, C90: 1u; C_0603_1608Metric_Pad1.05x0.95mm_HandSolder; Part ID GRT188R61H105KE13D
C110: 10u; C_0603_1608Metric_Pad1.05x0.95mm_HandSolder; Part ID ZRB18AR61E106ME01L
D6, D7: RCLAMP0524PATCT; SLP2510P8
F1: MF-FSMF020X-2; L_0603_1608Metric_Pad1.05x0.95mm_HandSolder
FB1, FB2, FB4: MPZ1608S221A; L_0603_1608Metric_Pad1.05x0.95mm_HandSolder
J1: HDMI_CONN (10029449-111RLF); HDMI_CONN-10029449-111RLF; Part ID 10029449-111RLF
R25: 698 1%; R_0603_1608Metric_Pad1.05x0.95mm_HandSolder
R26: 1k; R_0603_1608Metric_Pad1.05x0.95mm_HandSolder
R41, R45, R46: 4.7k; R_0603_1608Metric_Pad1.05x0.95mm_HandSolder
U3: IT6613E; TQFP-100_custom
U15, U16: TLV70018DDCT; SOT-23-5_Handsoldering

Connections:
/fpga1/HDMITX_B0: U3.94 (D4); also elsewhere on the board
/fpga1/HDMITX_B1: U3.93 (D5); also elsewhere on the board
/fpga1/HDMITX_B2: U3.92 (D6); also elsewhere on the board
/fpga1/HDMITX_B3: U3.91 (D7); also elsewhere on the board
/fpga1/HDMITX_B4: U3.90 (D8); also elsewhere on the board
/fpga1/HDMITX_B5: U3.86 (D9); also elsewhere on the board
/fpga1/HDMITX_B6: U3.85 (D10); also elsewhere on the board
/fpga1/HDMITX_B7: U3.84 (D11); also elsewhere on the board
/fpga1/HDMITX_DE: U3.1 (DE); also elsewhere on the board
/fpga1/HDMITX_G0: U3.79 (D16); also elsewhere on the board
/fpga1/HDMITX_G1: U3.78 (D17); also elsewhere on the board
/fpga1/HDMITX_G2: U3.77 (D18); also elsewhere on the board
/fpga1/HDMITX_G3: U3.75 (D19); also elsewhere on the board
/fpga1/HDMITX_G4: U3.74 (D20); also elsewhere on the board
/fpga1/HDMITX_G5: U3.73 (D21); also elsewhere on the board
/fpga1/HDMITX_G6: U3.72 (D22); also elsewhere on the board
/fpga1/HDMITX_G7: U3.71 (D23); also elsewhere on the board
/fpga1/HDMITX_HSYNC: U3.2 (HSYNC); also elsewhere on the board
/fpga1/HDMITX_INT_N: U3.24 (INTn); also elsewhere on the board
/fpga1/HDMITX_PCLK: U3.88 (PCLK); also elsewhere on the board
/fpga1/HDMITX_R0: U3.63 (D28); also elsewhere on the board
/fpga1/HDMITX_R1: U3.62 (D29); also elsewhere on the board
/fpga1/HDMITX_R2: U3.61 (D30); also elsewhere on the board
/fpga1/HDMITX_R3: U3.60 (D31); also elsewhere on the board
/fpga1/HDMITX_R4: U3.59 (D32); also elsewhere on the board
/fpga1/HDMITX_R5: U3.58 (D33); also elsewhere on the board
/fpga1/HDMITX_R6: U3.57 (D34); also elsewhere on the board
/fpga1/HDMITX_R7: U3.56 (D35); also elsewhere on the board
/fpga1/HDMITX_VSYNC: U3.3 (VSYNC); also elsewhere on the board
/fpga1/RESET_N: U3.25 (SYSRSTN); also elsewhere on the board
/fpga1/SCL: U3.48 (PCSCL); also elsewhere on the board
/fpga1/SDA: U3.49 (PCSDA); also elsewhere on the board
/hdmitx1/5V: F1.1; also elsewhere on the board
/hdmitx1/5V_FUSED: F1.2, J1.18 (+5V), R45.1, R46.1
/hdmitx1/AVCC1V8: C90.1, FB1.1, FB2.1, FB4.1, R25.2, U16.5 (OUT)
/hdmitx1/AVCC3V3: C81.1, U3.44 (AVCC33); also elsewhere on the board
/hdmitx1/DDC_SCL: J1.15 (SCL), R46.2, U3.46 (DDCSCL)
/hdmitx1/DDC_SDA: J1.16 (SDA), R45.2, U3.47 (DDCSDA)
/hdmitx1/DVDD1V8: C69.1, C75.1, C82.1, C84.1, C85.1, C89.1, C110.1, U3.12 (IVDD), U3.55 (IVDD), U3.64 (IVDD), U3.76 (IVDD), U3.99 (IVDD), U15.5 (OUT); also elsewhere on the board
/hdmitx1/HPD: J1.19 (HPD), R41.1, U3.51 (HPD)
/hdmitx1/I2S_BCK: U3.11 (SCK); also elsewhere on the board
/hdmitx1/I2S_DATA: U3.9 (I2S0); also elsewhere on the board
/hdmitx1/I2S_LRCK: U3.10 (WS); also elsewhere on the board
/hdmitx1/TMDS_CLK+: D7.4, D7.7, J1.10 (TMDS_CLK+), U3.31 (TXCP)
/hdmitx1/TMDS_CLK-: D7.5, D7.6, J1.12 (TMDS_CLK-), U3.30 (TXCM)
/hdmitx1/TMDS_D0+: D7.1, D7.10, J1.7 (TMDS_D0+), U3.34 (TX0P)
/hdmitx1/TMDS_D0-: D7.2, D7.9, J1.9 (TMDS_D0-), U3.33 (TX0M)
/hdmitx1/TMDS_D1+: D6.4, D6.7, J1.4 (TMDS_D1+), U3.37 (TX1P)
/hdmitx1/TMDS_D1-: D6.5, D6.6, J1.6 (TMDS_D1-), U3.36 (TX1M)
/hdmitx1/TMDS_D2+: D6.1, D6.10, J1.1 (TMDS_D2+), U3.40 (TX2P)
/hdmitx1/TMDS_D2-: D6.2, D6.9, J1.3 (TMDS_D2-), U3.39 (TX2M)
/soundbox/MCLK: U3.5 (MCLK); also elsewhere on the board
GND: C69.2, C73.2, C74.2, C75.2, C77.2, C78.2, C79.2, C80.2, C81.2, C82.2, C83.2, C84.2, C85.2, C86.2, C87.2, C88.2, C89.2, C90.2, C110.2, D6.3, D6.8, D7.3, D7.8, J1.2 (TMDS_D2_GND), J1.5 (TMDS_D1_GND), J1.8 (TMDS_D0_GND), J1.11 (TMDS_CLK_GND), J1.17 (DDC_GND), R26.2, R41.2, U3.4 (SPDIF), U3.6 (I2S3), U3.7 (I2S2), U3.8 (I2S1), U3.13 (IOVSS), U3.15 (DCLK), U3.16 (DSD0R), U3.17 (DSD0L), U3.18 (DSD1R), U3.19 (DSD1L), U3.20 (DSD2R), U3.21 (DSD2L), U3.22 (DSD3R), U3.23 (DSD3L), U3.26 (PGND1), U3.29 (AGND), U3.35 (AGND), U3.41 (AGND), U3.43 (PGND2), U3.50 (PCADR), U3.54 (IOVSS), U3.65 (IOVSS), U3.67 (D27), U3.68 (D26), U3.69 (D25), U3.70 (D24), U3.80 (D15), U3.81 (D14), U3.82 (D13), U3.83 (D12), U3.87 (IOVSS), U3.95 (D3), U3.96 (D2), U3.97 (D1), U3.98 (D0), U3.100 (IOVSS), U15.2 (GND), U16.2 (GND); also elsewhere on the board
unnamed: C77.1, C78.1, FB2.2, U3.32 (AVCC18), U3.38 (AVCC18)
unnamed: R26.1, U3.52 (ENTEST)
unnamed: C74.1, FB1.2, U3.28 (PVCC1)
unnamed: C80.1, FB4.2, U3.42 (PVCC2)
unnamed: R25.1, U3.27 (REXT)
VCC: C73.1, C79.1, C83.1, C86.1, C87.1, C88.1, U3.14 (OVDD), U3.53 (OVDD), U3.66 (OVDD), U3.89 (OVDD), U15.1 (IN), U15.3 (~EN), U16.1 (IN), U16.3 (~EN); also elsewhere on the board

Notes on the sheet:
max. 127mA (DVDD18)
max. 55mA
max. 200mA
max. 55mA (AVCC18)
max. 1mA (OVDD)
max. 1mA (AVCC33)

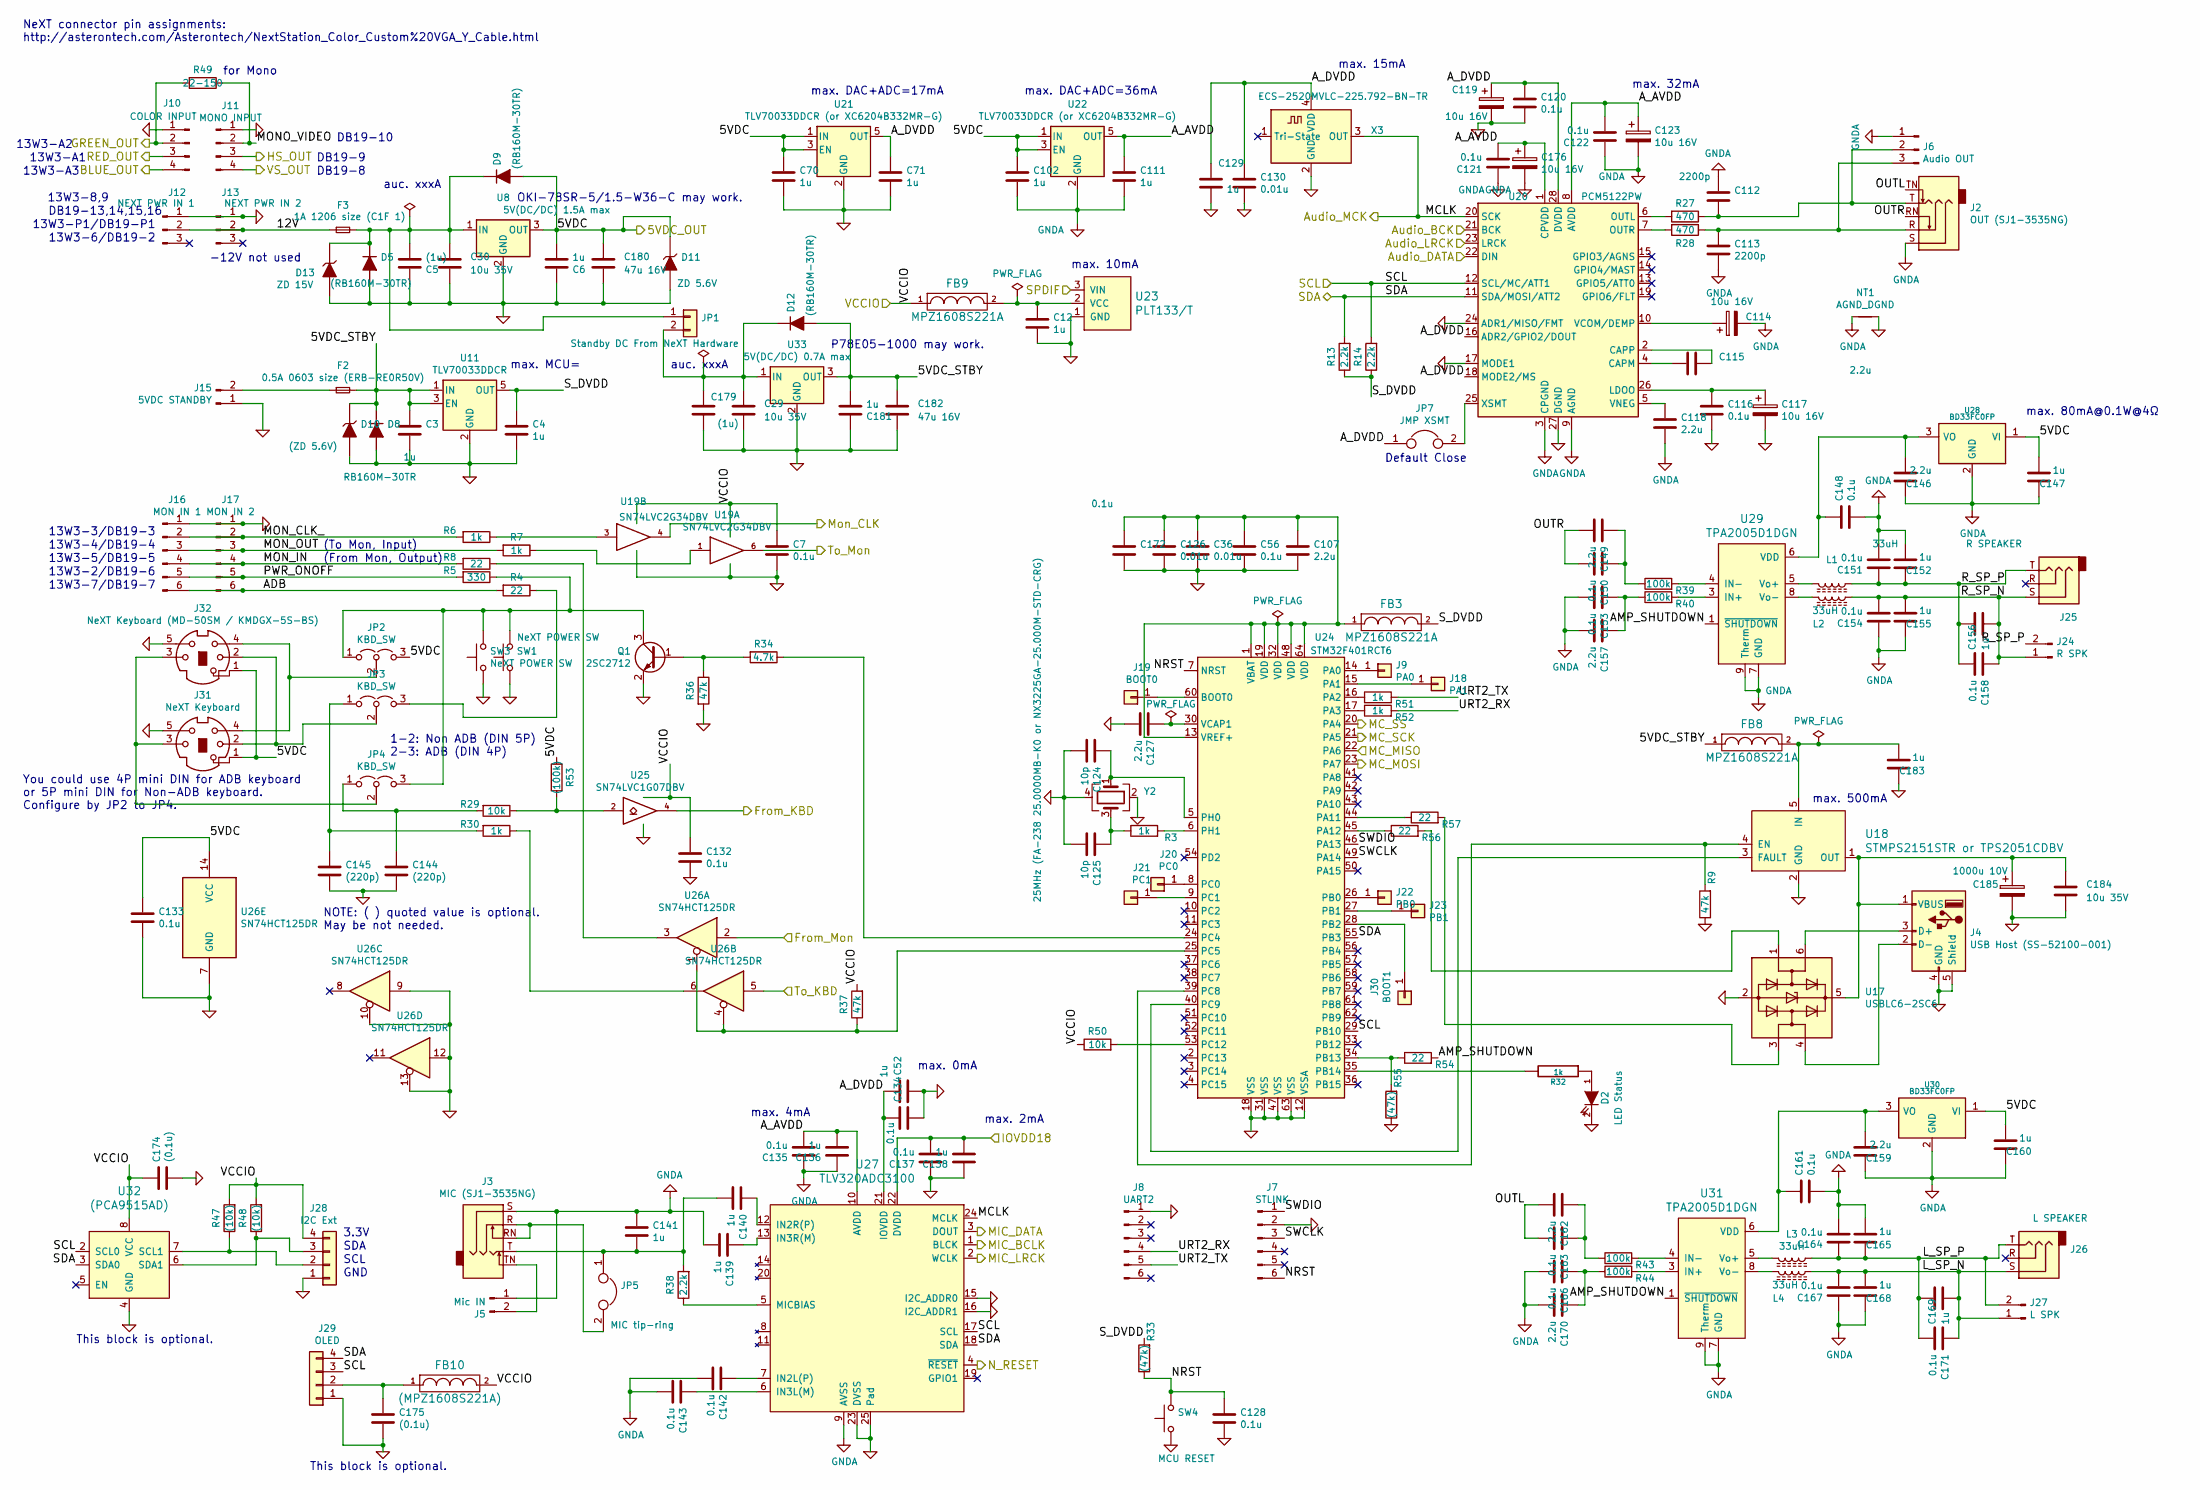
[picture p10: schematic soundbox.kicad_sch]

Parts:
C3, C4, C6, C12, C52, C70, C71, C102, C111, C129, C136, C138, C139, C140, C141, C147, C152, C155, C156, C160, C165, C168, C169, C181, C183: 1u; C_0603_1608Metric_Pad1.05x0.95mm_HandSolder; Part ID GRT188R61H105KE13D
C5, C179: (1u); C_0603_1608Metric_Pad1.08x0.95mm_HandSolder; Part ID GRT188R61H105KE13D
C7, C56, C116, C120, C121, C122, C128, C132, C133, C134, C135, C137, C142, C143, C148, C150, C151, C153, C154, C158, C161, C163, C164, C166, C167, C171, C172: 0.1u; C_0603_1608Metric_Pad1.05x0.95mm_HandSolder; Part ID GCJ188R71H104KA12D or GRM188R72A104MA35D
C29, C30, C184: 10u 35V; C_1210_3225Metric_Pad1.33x2.70mm_HandSolder; Part ID GRM32ER7YA106KA12
C36, C126, C130: 0.01u; C_0603_1608Metric_Pad1.05x0.95mm_HandSolder; Part ID GCM188R72A103KA37J
C107, C115, C118, C127, C146, C149, C157, C159, C162, C170: 2.2u; C_0603_1608Metric_Pad1.05x0.95mm_HandSolder; Part ID GRM188R71A225KE15D
C112, C113: 2200p; C_0603_1608Metric_Pad1.05x0.95mm_HandSolder; Part ID GRM1885C1H222JA01J
C114, C117, C119, C123, C176: 10u 16V; CP_Elec_4x4.5; Part ID EEE-FK1C100AR or HB Series
C124, C125: 10p; C_0603_1608Metric_Pad1.05x0.95mm_HandSolder
C144, C145: (220p); C_0603_1608Metric_Pad1.05x0.95mm_HandSolder
C174, C175: (0.1u); C_0603_1608Metric_Pad1.05x0.95mm_HandSolder
C180, C182: 47u 16V; C_1210_3225Metric_Pad1.33x2.70mm_HandSolder; Part ID GRM32EC81C476KE15L
C185: 1000u 10V; C_Disc_D8.0mm_W2.5mm_P5.00mm; Part ID 10WXA1000MEFC10X9
D2: LED Status; LED_D3.0mm_Horizontal_O1.27mm_Z6.0mm
D5, D9, D12: (RB160M-30TR); D_SOD-123_HandSoldering
D8: RB160M-30TR; D_SOD-123_HandSoldering
D10: (ZD 5.6V); D_SMB_Handsoldering; Part ID 1SMB5919BT3G
D11: ZD 5.6V; D_SMB_Handsoldering; Part ID 1SMB5919BT3G
D13: ZD 15V; D_SMA; Part ID 1SMB5919BT3G
F2: 0.5A 0603 size (ERB-RE0R50V); Fuse_0603_1608Metric_Pad1.05x0.95mm_HandSolder
F3: 1A 1206 size (C1F 1); Fuse_1206_3216Metric_Pad1.42x1.75mm_HandSolder
FB3, FB8, FB9: MPZ1608S221A; L_0603_1608Metric_Pad1.05x0.95mm_HandSolder
FB10: (MPZ1608S221A); L_0603_1608Metric_Pad1.05x0.95mm_HandSolder
J2: OUT (SJ1-3535NG); SJ1-3535NG
J3: MIC (SJ1-3535NG); SJ1-3535NG
J4: USB Host (SS-52100-001); USB_A_Stewart_SS-52100-001_Horizontal
J5: Mic IN; JST_XH_B2B-XH-A_1x02_P2.50mm_Vertical
J6: Audio OUT; JST_XH_B3B-XH-A_1x03_P2.50mm_Vertical
J7: STLINK; PinHeader_1x06_P2.54mm_Vertical
J8: UART2; PinHeader_1x06_P2.54mm_Vertical
J9: PA0; TestPad-D1.0mm
J10: COLOR INPUT; JST_XH_B4B-XH-A_1x04_P2.50mm_Vertical
J11: MONO INPUT; JST_XH_B4B-XH-A_1x04_P2.50mm_Vertical
J12: NEXT PWR IN 1; JST_XH_B3B-XH-A_1x03_P2.50mm_Vertical
J13: NEXT PWR IN 2; JST_XH_B3B-XH-A_1x03_P2.50mm_Vertical
J15: 5VDC STANDBY; JST_XH_B2B-XH-A_1x02_P2.50mm_Vertical
J16: MON IN 1; JST_XH_B6B-XH-A_1x06_P2.50mm_Vertical
J17: MON IN 2; JST_XH_B6B-XH-A_1x06_P2.50mm_Vertical
J18: PA1; TestPad-D1.0mm
J19: BOOT0; TestPad-D1.0mm
J20: PC0; TestPad-D1.0mm
J21: PC1; TestPad-D1.0mm
J22: PB0; TestPad-D1.0mm
J23: PB1; TestPad-D1.0mm
J24: R SPK; JST_XH_B2B-XH-A_1x02_P2.50mm_Vertical
J25: R SPEAKER; SJ-2509N; Part ID SJ-2509N
J26: L SPEAKER; SJ-2509N; Part ID SJ-2509N
J27: L SPK; JST_XH_B2B-XH-A_1x02_P2.50mm_Vertical
J28: I2C Ext; JST_XH_B4B-XH-A_1x04_P2.50mm_Vertical
J29: OLED; OLED_0.91inch_I2C
J30: BOOT1; TestPad-D1.0mm
J31: NeXT Keyboard; Mini_DIN_5P
J32: NeXT Keyboard (MD-50SM / KMDGX-5S-BS); Mini_DIN_5P; Part ID MD-50SM / KMDGX-5S-BS
JP1: Standby DC From NeXT Hardware; PinHeader_1x02_P2.54mm_Vertical
JP2, JP3, JP4: KBD_SW; SolderJumper-3_P1.3mm_Open_RoundedPad1.0x1.5mm_NumberLabels
JP5: MIC tip-ring; SolderJumper-2_P1.3mm_Open_RoundedPad1.0x1.5mm
JP7: JMP XSMT; SolderJumper-2_P1.3mm_Bridged_RoundedPad1.0x1.5mm
L1, L2, L3, L4: 33uH; L_TDK_SLF7045_HandSoldering; Part ID SLF7045T-330MR
NT1: AGND_DGND; NetTie-2_SMD_Pad2.0mm
Q1: 2SC2712; SC-59_Handsoldering
R3, R6, R7, R30, R32, R51, R52: 1k; R_0603_1608Metric_Pad1.05x0.95mm_HandSolder
R4, R8: 22; R_0603_1608Metric_Pad1.05x0.95mm_HandSolder
R5: 330; R_0603_1608Metric_Pad1.05x0.95mm_HandSolder
R9, R36, R37: 47k; R_0603_1608Metric_Pad1.05x0.95mm_HandSolder
R13, R14, R38: 2.2k; R_0603_1608Metric_Pad1.05x0.95mm_HandSolder
R27, R28: 470; R_0603_1608Metric_Pad1.05x0.95mm_HandSolder
R29, R50: 10k; R_0603_1608Metric_Pad1.05x0.95mm_HandSolder
R33: (47k); R_0603_1608Metric_Pad1.05x0.95mm_HandSolder
R34: 4.7k; R_0603_1608Metric_Pad1.05x0.95mm_HandSolder
R39, R40, R43, R44: 100k; R_0603_1608Metric_Pad1.05x0.95mm_HandSolder
R47, R48: (10k); R_0603_1608Metric_Pad1.05x0.95mm_HandSolder
R49: 22-150; R_0603_1608Metric_Pad1.05x0.95mm_HandSolder
R53: (100k); R_0603_1608Metric_Pad1.05x0.95mm_HandSolder
R54, R56, R57: 22; R_0603_1608Metric_Pad0.98x0.95mm_HandSolder
R55: (47k); R_0603_1608Metric_Pad0.98x0.95mm_HandSolder
SW1, SW3: NeXT POWER SW; SW_Tactile_SKHH_Angled; Part ID (1-1825027-1 / 2-1825027-0)
SW4: MCU RESET; SW_PUSH_6mm
U8: 5V(DC/DC) 1.5A max; TO-220-3_Vertical; Part ID OKI-78SR-5/1.5-W36-C
U11: TLV70033DDCR; SOT-23-5_Handsoldering
U17: USBLC6-2SC6; SOT-23-6_Handsoldering
U18: STMPS2151STR‎ or TPS2051CDBV; SOT-23-5_HandSoldering
U19: SN74LVC2G34DBV; SOT-23-6_Handsoldering
U20: PCM5122PW; TSSOP-28_4.4x9.7mm_P0.65mm
U21, U22: TLV70033DDCR (or XC6204B332MR-G); SOT-23-5_Handsoldering
U23: PLT133/T; PLT133_T
U24: STM32F401RCT6; LQFP-64_10x10mm_P0.5mm
U25: SN74LVC1G07DBV; SOT-23-5_HandSoldering
U26: SN74HCT125DR; SOIC-14_3.9x8.7mm_P1.27mm
U27: TLV320ADC3100; VQFN-24-1EP_4x4mm_P0.5mm_EP2.45x2.45mm
U28, U30: BD33FC0FP; TO-252-2
U29, U31: TPA2005D1DGN; MSOP-8-1EP_3x3mm_P0.65mm_EP1.73x1.85mm
U32: (PCA9515AD); SOIC-8_3.9x4.9mm_P1.27mm
U33: 5V(DC/DC) 0.7A max; TO-220-3_Vertical; Part ID P78E05-1000
X3: ECS-2520MVLC-225.792-BN-TR; Oscillator_SMD_SeikoEpson_SG210-4Pin_2.5x2.0mm_HandSoldering
Y2: 25MHz (FA-238 25.0000MB-K0 or NX3225GA-25.000M-ST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; Crystal_SMD_SeikoEpson_TSX3225-4Pin_3.2x2.5mm_HandSoldering

Connections:
/MC_MISO: U24.22 (PA6); also elsewhere on the board
/MC_MOSI: U24.23 (PA7); also elsewhere on the board
/MC_SCK: U24.21 (PA5); also elsewhere on the board
/MC_SS: U24.20 (PA4); also elsewhere on the board
/fpga1/BTN0: U25.4; also elsewhere on the board
/fpga1/FromMon: U26.2; also elsewhere on the board
/fpga1/LED0: U23.3 (VIN); also elsewhere on the board
/fpga1/Mic_BCLK: U27.1 (BLCK); also elsewhere on the board
/fpga1/Mic_Data: U27.3 (DOUT); also elsewhere on the board
/fpga1/Mic_LRCK: U27.2 (WCLK); also elsewhere on the board
/fpga1/MonCLKin: U19.4; also elsewhere on the board
/fpga1/RESET_N: U27.4 (~RESET); also elsewhere on the board
/fpga1/SCL: J29.3, R14.2, U20.12 (SCL/MC/ATT1), U24.29 (PB10), U27.17 (SCL), U32.2 (SCL0); also elsewhere on the board
/fpga1/SDA: J29.4, R13.2, U20.11 (SDA/MOSI/ATT2), U24.55 (PB3), U27.18 (SDA), U32.3 (SDA0); also elsewhere on the board
/fpga1/ToKBD: U26.5; also elsewhere on the board
/fpga1/ToMon: U19.6; also elsewhere on the board
/hdmitx1/5V: C6.2, C70.1, C102.1, C133.1, C147.2, C160.2, C180.1, D9.2 (A), D11.1 (K), J31.1, J32.1, JP2.3 (B), R53.2, U8.3 (OUT), U21.1 (IN), U21.3 (EN), U22.1 (IN), U22.3 (EN), U26.14 (VCC), U28.1 (VI), U30.1 (VI); also elsewhere on the board
/hdmitx1/DVDD1V8: C137.2, C138.2, U27.22 (DVDD); also elsewhere on the board
/hdmitx1/I2S_BCK: U20.21 (BCK); also elsewhere on the board
/hdmitx1/I2S_DATA: U20.22 (DIN); also elsewhere on the board
/hdmitx1/I2S_LRCK: U20.23 (LRCK); also elsewhere on the board
/soundbox/5VDC_STBY: C3.1, C181.2, C182.1, D8.1 (K), D10.1 (K), D12.2 (A), F2.2, FB8.1, U11.1 (IN), U11.3 (EN), U33.3 (OUT)
/soundbox/12V: F3.1, J12.2, J13.2
/soundbox/ADB: J16.6, J17.6, R4.2
/soundbox/AMP_SHUTDOWN: R54.2, U29.1 (~SHUTDOWN), U31.1 (~SHUTDOWN)
/soundbox/A_AVDD: C111.1, C121.2, C122.2, C123.1, C135.2, C136.2, C176.1, U20.1 (CPVDD), U20.8 (AVDD), U22.5 (OUT), U27.10 (AVDD)
/soundbox/A_DVDD: C52.1, C71.1, C119.1, C120.1, C129.1, C130.1, C134.1, JP7.1, U20.16 (ADR2/GPIO2/DOUT), U20.18 (MODE2/MS), U20.28 (DVDD), U21.5 (OUT), U27.21 (IOVDD), X3.4 (VDD)
/soundbox/L_SP_N: C167.2, C168.2, C169.2, C171.1, J26.S, J27.1, L4.1
/soundbox/L_SP_P: C164.1, C165.1, C169.1, C171.2, J26.T, J27.2, L3.1
/soundbox/MCLK: U20.20 (SCK), U27.24 (MCLK), X3.3 (OUT); also elsewhere on the board
/soundbox/MONO_VIDEO: J11.2, R49.1
/soundbox/MON_CLK_: J16.2, J17.2, R6.2
/soundbox/MON_IN: J16.4, J17.4, R8.2
/soundbox/MON_OUT: J16.3, J17.3, R7.2
/soundbox/NRST: C128.1, J7.6, R33.1, SW4.2, U24.7 (NRST)
/soundbox/OUTL: C162.2, C163.2, J2.TN
/soundbox/OUTR: C149.2, C150.2, J2.RN
/soundbox/PWR_ONOFF: J16.5, J17.5, R5.2
/soundbox/R_SP_N: C154.2, C155.2, C156.2, C158.1, J24.1, J25.S, L2.1
/soundbox/R_SP_P: C151.1, C152.1, C156.1, C158.2, J24.2, J25.T, L1.1
/soundbox/SWCLK: J7.3, U24.49 (PA14)
/soundbox/SWDIO: J7.1, U24.46 (PA13)
/soundbox/S_DVDD: C4.1, FB3.2, R13.1, R14.1, R33.2, U11.5 (OUT)
/soundbox/URT2_RX: J8.4, R52.2
/soundbox/URT2_TX: J8.5, R51.2
/tvp_board1/RGB3_B: J10.4; also elsewhere on the board
/tvp_board1/RGB3_G: J10.2, R49.2; also elsewhere on the board
/tvp_board1/RGB3_HS: J11.3; also elsewhere on the board
/tvp_board1/RGB3_R: J10.3; also elsewhere on the board
/tvp_board1/RGB3_VS: J11.4; also elsewhere on the board
GND: C3.2, C4.2, C5.1, C6.1, C7.2, C12.2, C29.2, C30.2, C36.2, C52.2, C56.2, C70.2, C71.2, C107.2, C116.2, C117.2, C119.2, C120.2, C124.2, C125.2, C126.2, C127.2, C128.2, C129.2, C130.2, C132.2, C133.2, C134.2, C137.1, C138.1, C144.2, C145.2, C172.2, C174.2, C175.2, C179.1, C180.2, C181.1, C182.2, C183.1, C184.2, C185.2, D2.2 (K), D5.2 (A), D8.2 (A), D10.2 (A), D11.2 (A), D13.2 (A), J4.4 (GND), J4.5 (Shield), J7.2, J8.1, J10.1, J11.1, J12.1, J13.1, J15.1, J16.1, J17.1, J28.1, J29.1, J31.5, J32.5, NT1.2, Q1.2 (E), R9.1, R36.2, R55.1, SW1.1, SW3.1, SW4.1, U8.2 (GND), U11.2 (GND), U17.2 (GND), U18.2 (GND), U19.2 (GND), U20.17 (MODE1), U20.24 (ADR1/MISO/FMT), U20.27 (DGND), U21.2 (GND), U23.1 (GND), U24.12 (VSSA), U24.18 (VSS), U24.31 (VSS), U24.47 (VSS), U24.63 (VSS), U25.3 (GND), U26.7 (GND), U26.9, U26.10, U26.12, U26.13, U27.15 (I2C_ADDR0), U27.16 (I2C_ADDR1), U27.23 (DVSS), U27.25 (Pad), U32.4 (GND), U33.2 (GND), X3.2 (GND), Y2.2, Y2.4; also elsewhere on the board
GNDA: C102.2, C111.2, C112.1, C113.2, C114.2, C118.2, C121.1, C122.1, C123.2, C135.1, C136.1, C139.2, C141.1, C142.2, C143.2, C146.1, C147.1, C148.2, C151.2, C152.2, C153.2, C154.1, C155.1, C157.2, C159.1, C160.1, C161.2, C164.2, C165.2, C166.2, C167.1, C168.1, C170.2, C176.2, J2.S, J3.S, J5.1, J6.1, NT1.1, U20.3 (CPGND), U20.9 (AGND), U22.2 (GND), U27.9 (AVSS), U28.2 (GND), U29.7 (GND), U29.9 (Therm), U30.2 (GND), U31.7 (GND), U31.9 (Therm)
unnamed: C125.1, R3.1, Y2.3
unnamed: C140.2, C141.2, J3.T, JP5.1, R38.2
unnamed: C149.1, C150.1, R39.1
unnamed: C153.1, C157.1, R40.1
unnamed: C162.1, C163.1, R43.1
unnamed: C166.1, C170.1, R44.1
unnamed: D2.1 (A), R32.1
unnamed: C29.1, C179.2, D12.1 (K), JP1.2, U33.1 (IN)
unnamed: C5.2, C30.1, D5.1 (K), D9.1 (K), D13.1 (K), F3.2, JP1.1, U8.1 (IN)
unnamed: J3.R, J3.RN, JP5.2
unnamed: J4.3 (D+), U17.6 (I/O1)
unnamed: J4.2 (D-), U17.4 (I/O2)
unnamed: C184.1, C185.1, J4.1 (VBUS), U17.5 (VBUS), U18.1 (OUT)
unnamed: J3.TN, J5.2
unnamed: C112.2, J2.T, J6.2, R27.1
unnamed: C113.1, J2.R, J6.3, R28.1
unnamed: J9.1 (Pin_1_1), U24.14 (PA0)
unnamed: F2.1, J15.2
unnamed: J18.1 (Pin_1_1), U24.15 (PA1)
unnamed: J19.1 (Pin_1_1), U24.60 (BOOT0)
unnamed: J20.1 (Pin_1_1), U24.8 (PC0)
unnamed: J21.1 (Pin_1_1), U24.9 (PC1)
unnamed: J22.1 (Pin_1_1), U24.26 (PB0)
unnamed: J23.1 (Pin_1_1), U24.27 (PB1)
unnamed: J28.2, R47.1, U32.7 (SCL1)
unnamed: J28.3, R48.1, U32.6 (SDA1)
unnamed: C175.1, FB10.1, J29.2
unnamed: J30.1 (Pin_1_1), U24.28 (PB2)
unnamed: JP2.1 (A), JP4.3 (B), Q1.3 (C), R5.1, SW1.2, SW3.2
unnamed: J31.4, J32.4, JP2.2 (C)
unnamed: C145.1, JP3.1 (A), R30.2
unnamed: JP3.3 (B), R4.1
unnamed: J31.2, J32.2, JP3.2 (C)
unnamed: C144.1, JP4.1 (A), R29.2
unnamed: J31.3, J32.3, JP4.2 (C)
unnamed: Q1.1 (B), R34.2, R36.1
unnamed: R6.1, U19.3
unnamed: R7.1, U19.1
unnamed: R8.1, U26.3
unnamed: R29.1, R53.1, U25.2
unnamed: R30.1, U26.6
unnamed: R56.2, U17.1 (I/O1)
unnamed: R57.2, U17.3 (I/O2)
unnamed: R9.2, U18.4 (EN), U24.39 (PC8)
unnamed: U18.3 (FAULT), U24.40 (PC9)
unnamed: C183.2, FB8.2, U18.5 (IN)
unnamed: C115.1, U20.4 (CAPM)
unnamed: C115.2, U20.2 (CAPP)
unnamed: C116.1, C117.1, U20.26 (LDOO)
unnamed: R27.2, U20.6 (OUTL)
unnamed: R28.2, U20.7 (OUTR)
unnamed: C114.1, U20.10 (VCOM/DEMP)
unnamed: C118.1, U20.5 (VNEG)
unnamed: JP7.2, U20.25 (XSMT)
unnamed: C12.1, FB9.2, U23.2 (VCC)
unnamed: R51.1, U24.16 (PA2)
unnamed: R52.1, U24.17 (PA3)
unnamed: R57.1, U24.44 (PA11)
unnamed: R56.1, U24.45 (PA12)
unnamed: R54.1, R55.2, U24.34 (PB13)
unnamed: R32.2, U24.35 (PB14)
unnamed: R34.1, U24.24 (PC4)
unnamed: R37.1, U24.25 (PC5), U26.1, U26.4
unnamed: R50.2, U24.53 (PC12)
unnamed: C124.1, U24.5 (PH0), Y2.1
unnamed: R3.2, U24.6 (PH1)
unnamed: C36.1, C56.1, C107.1, C126.1, C172.1, FB3.1, U24.1 (VBAT), U24.13 (VREF+), U24.19 (VDD), U24.32 (VDD), U24.48 (VDD), U24.64 (VDD)
unnamed: C127.1, U24.30 (VCAP1)
unnamed: C142.1, U27.7 (IN2L(P))
unnamed: C140.1, U27.12 (IN2R(P))
unnamed: C143.1, U27.6 (IN3L(M))
unnamed: C139.1, U27.13 (IN3R(M))
unnamed: R38.1, U27.5 (MICBIAS)
unnamed: C146.2, C148.1, U28.3 (VO), U29.6 (VDD)
unnamed: R40.2, U29.3 (IN+)
unnamed: R39.2, U29.4 (IN-)
unnamed: L1.2, U29.5 (Vo+)
unnamed: L2.2, U29.8 (Vo-)
unnamed: C159.2, C161.1, U30.3 (VO), U31.6 (VDD)
unnamed: R44.2, U31.3 (IN+)
unnamed: R43.2, U31.4 (IN-)
unnamed: L3.2, U31.5 (Vo+)
unnamed: L4.2, U31.8 (Vo-)
VCC: C7.1, C132.1, C174.1, FB9.1, FB10.2, J28.4, R37.2, R47.2, R48.2, R50.1, U19.5 (VCC), U25.5 (VCC), U32.8 (VCC); also elsewhere on the board

Notes on the sheet:
13W3-A3
13W3-4/DB19-4
OKI-78SR-5/1.5-W36-C may work.
13W3-A1
-12V not used
auc. xxxA
max. 2mA
max. 4mA
DB19-8
13W3-3/DB19-3
NOTE: ( ) quoted value is optional. May be not needed.
13W3-P1/DB19-P1
DB19-9
SCL
(To Mon, Input)
(From Mon, Output)
13W3-5/DB19-5
max. DAC+ADC=17mA
P78E05-1000 may work.
13W3-6/DB19-2
DB19-10
max. 10mA
13W3-2/DB19-6
max. 0mA
max. MCU=
NeXT connector pin assignments: http://asterontech.com/Asterontech/NextStation_Color_Custom%20VGA_Y_Cable.html
for Mono
max. 500mA
You could use 4P mini DIN for ADB keyboard or 5P mini DIN for Non-ADB keyboard. Configure by JP2 to JP4.
13W3-8,9
This block is optional.
DB19-13,14,15,16
13W3-7/DB19-7
max. 15mA
max. 32mA
GND
13W3-A2
SDA
max. DAC+ADC=36mA
max. 80mA@0.1W@4Ω
Default Close
1-2: Non ADB (DIN 5P) 2-3: ADB (DIN 4P)
3.3V

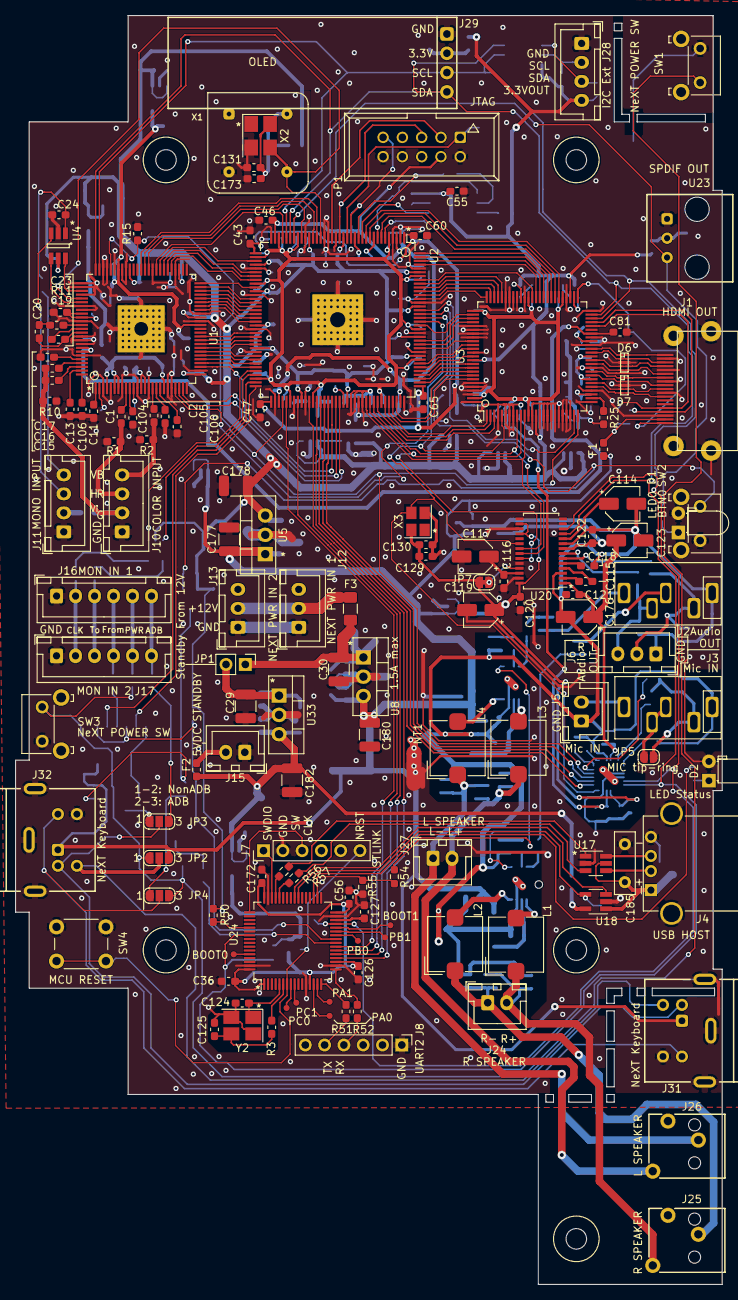
[picture p11: board ossc_board.kicad_pcb from above]

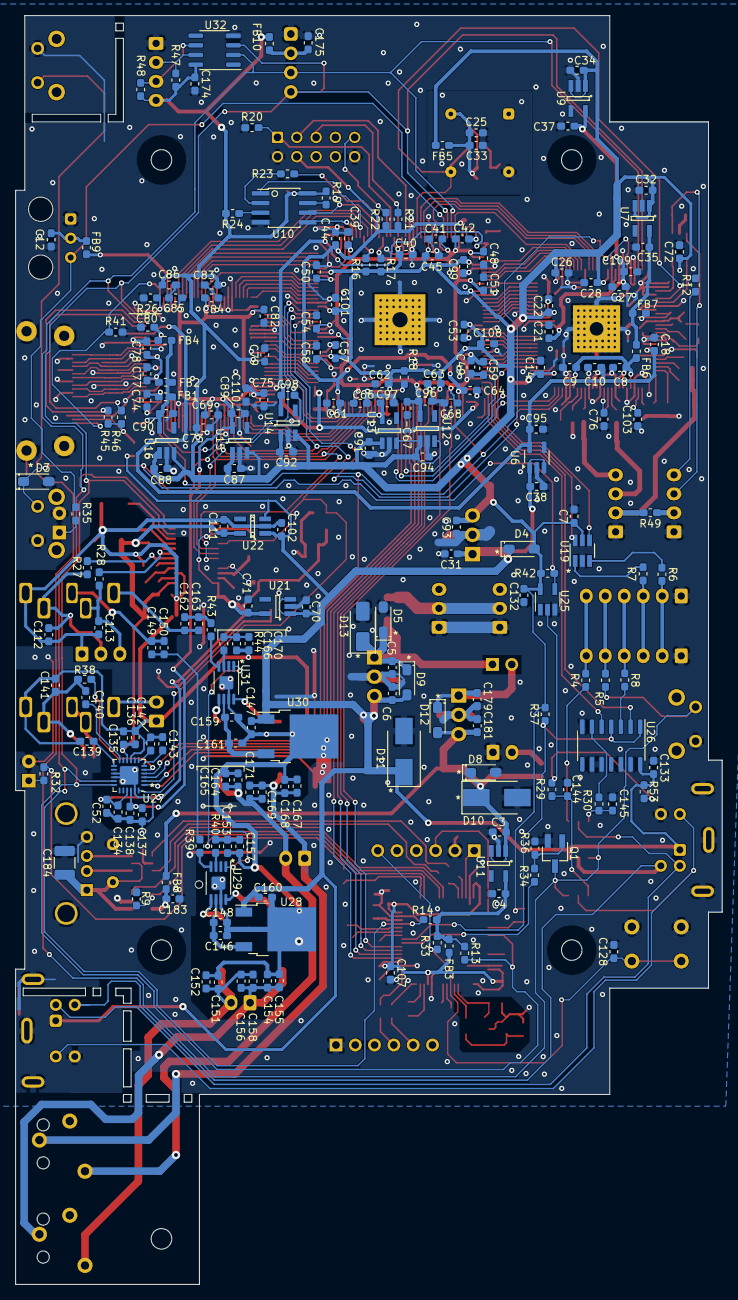
[picture p12: board ossc_board.kicad_pcb from below]

Board: 2 copper layers, 93.0 x 167.0 mm, 358 parts (217 on the bottom side), 256 nets.
