novi/ossc_pcb/(commit log)

2020-05-23 add test pins fix tracks
    [fpga.sch, hdmitx.sch, ossc_board.kicad_pcb, ossc_board.sch, tvp_board.sch]
2020-05-23 minor fix
    [ossc_board.kicad_pcb]
2020-05-24 generate gerber
    [ossc_board-B.Cu.gbl, ossc_board-B.Mask.gbs, ossc_board-B.SilkS.gbo, ossc_board-B_Cu.gbl, ossc_board-B_Mask.gbs, ossc_board-B_Paste.gbp, ossc_board-B_SilkS.gbo, ossc_board-Edge.Cuts.gm1]
2020-05-24 convert mechanical hole of the RGB connector into NPTH
    [ossc_board.kicad_pcb]
2020-07-25 remove unnecessary component
    [fpga.sch, hdmitx.sch, ossc_board.kicad_pcb, ossc_board.sch, tvp_board.sch]
2020-07-25 update the tracks
    [ossc_board.kicad_pcb]
2020-09-13 NeXT Sound Box function (1st rev) (#1)
    [fpga.sch, hdmitx.sch, nextcube-3-and-half-mo-mount.dxf, nextcube-ext-card.dxf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]
2020-09-16 add uart registors
    [ossc_board.kicad_pcb, soundbox.sch]
2020-09-21 add BOOT1 pad
    [ossc_board.kicad_pcb, soundbox.sch]
2020-10-04 connect XSMT (errata)
    [ossc_board.kicad_pcb, soundbox.sch]
2020-10-13 add protection zener
    [ossc_board.kicad_pcb, soundbox.sch]
2020-10-15 update crystal pattern
    [ossc_board.kicad_pcb]
2021-02-01 update mic lines
    [ossc_board.kicad_pcb, soundbox.sch]
2021-02-15 update zone
    [ossc_board.kicad_pcb]
2021-03-13 update value
    [ossc_board.kicad_pcb, soundbox.sch]
2021-03-13 add cube ext card base dimensions
    [nextcube-ext-card-soundbox-mount.dxf]
2021-03-13 move keyboard DIN connector
    [ossc_board.kicad_pcb]
2021-03-22 update cube sound box dimensions
    [nextcube-ext-card-soundbox-mount.dxf]
2021-03-27 update silk update mount plate
    [nextcube-ext-card-soundbox-mount.dxf, ossc_board.kicad_pcb]
2021-04-06 update dimension for cube sound box plate
    [nextcube-ext-card-soundbox-mount.dxf]
2021-05-24 change 3.3V liner regulator
    [ossc_board.kicad_pcb, tvp_board.sch]
2021-05-25 move front ADB connector treat shutdown pin of the amplifier
    [ossc_board.kicad_pcb, soundbox.sch]
2021-05-28 add base enclosure dxf
    [PF15-3-10D_20210228210419.dxf]
2021-05-28 minor update
    [ossc_board.kicad_pcb, soundbox.sch]
2021-05-28 value update
    [ossc_board.kicad_pcb, soundbox.sch, tvp_board.sch]
2021-05-28 add comment
    [ossc_board.kicad_pcb, soundbox.sch]
2021-05-28 update dxf
    [nextcube-ext-card-soundbox-mount.dxf]
2021-05-28 front panel
    [PF15-3-10D_20210228210419.dxf, ossc_board.kicad_pcb]
2021-05-31 add caps
    [ossc_board.kicad_pcb, soundbox.sch, tvp_board.sch]
2021-05-31 update values
    [fpga.sch, ossc_board.kicad_pcb, ossc_board.sch, soundbox.sch]
2021-06-02 add back panel outline
    [PF15-3-10D_20210228210419.dxf]
2021-06-05 plot gerber
    [ossc_board-B_Cu.gbl, ossc_board-B_Mask.gbs, ossc_board-B_Paste.gbp, ossc_board-B_SilkS.gbo, ossc_board-Edge_Cuts.gm1, ossc_board-F_Cu.gtl, ossc_board-F_Mask.gts, ossc_board-F_Paste.gtp]
2021-06-16 add register for usb impedance matching
    [ossc_board.kicad_pcb, soundbox.sch]
2021-06-25 fix silk
    [ossc_board.kicad_pcb]
2021-07-06 add new mount plate
    [nextcube-ext-card-mo-mount.dxf, nextcube-ext-card-soundbox-mount-alt1.dxf]
2021-07-11 update plate
    [nextcube-ext-card-soundbox-mount-alt1.dxf]
2021-07-11 update tracks
    [ossc_board.kicad_pcb]
2021-07-17 update case
2021-08-03 add BOM for the Sound Box
2022-03-19 migrated to KiCad 6
2024-05-17 migrated to KiCad 7
2024-05-18 change capacitors
2026-04-06 migrate to KiCad 10
2026-04-06 add zener diode
